villeautonome/Ville-Connectee/README.md

# Ville-Connectee
Création d'une ville connectée avec Arduino
