villeautonome/Ville-Connectee/rapport séances/Francesco/séance 5.md

# Cinquième séance du 3 Février 2023

- ##### Travail sur la base du projet

Durant ma cinquième séance j’ai commencé par tracer au crayon les différents éléments sur la base de notre nouvelle planche en bois pour avoir un aperçu de où placer chaque élément de notre projet. Ensuite on a fait des trou pour y faire passer les fils et composantes qu’on va placer à l’intérieur de la boîte. Voici le résultat:

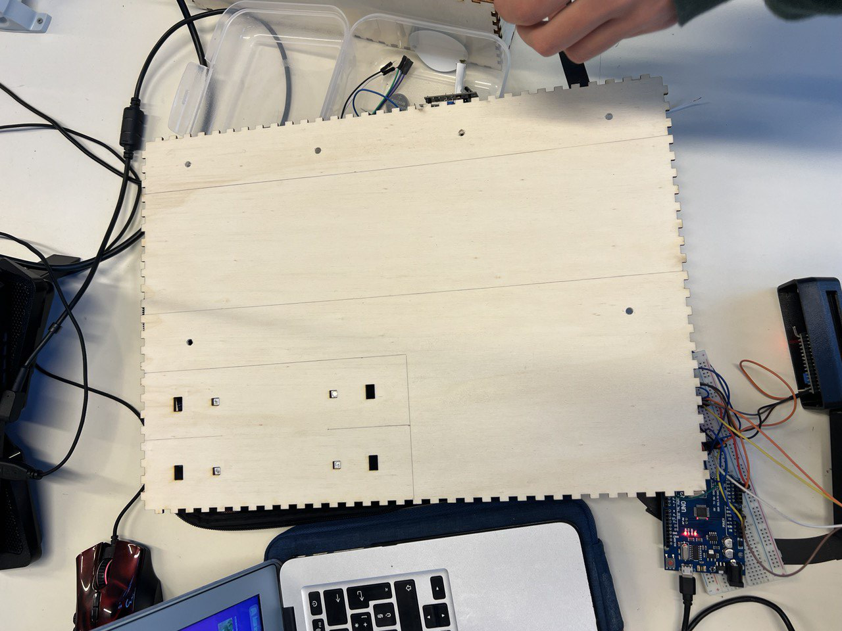
[picture p1: rapport séances/Francesco/images/planche_base.jpeg]
base du projet


- ##### "Création" de nouveaux capteurs de distance

On avait prévu d'utiliser un certain type de capteurs de distance pour notre projet, les capteurs TCRT5000, sauf qu'on en avait que 2 sur 4 du coup on a dû trouver une solution. J’ai alors soudé le capteur optique du TCRT5000 dans un capteur de proximité à infrarouges FC 51, parce que nous avions besoin de la forme rectangulaire du capteur optique du TCRT5000. Une fois la soudure complétée, j'ai vérifié que le capteur fonctionnait bien. On peut voir ici un capteur optique du TCRT5000 ainsi que le résultat final de la soudure:

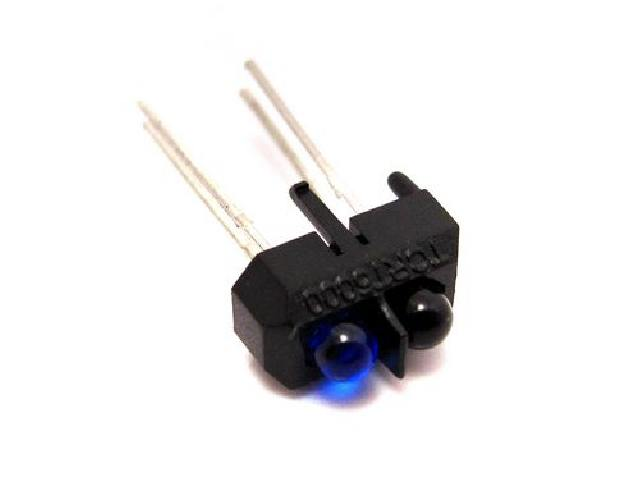
[picture p2: rapport séances/Francesco/images/tcrt5000.jpg]
capteur optique du TCRT5000

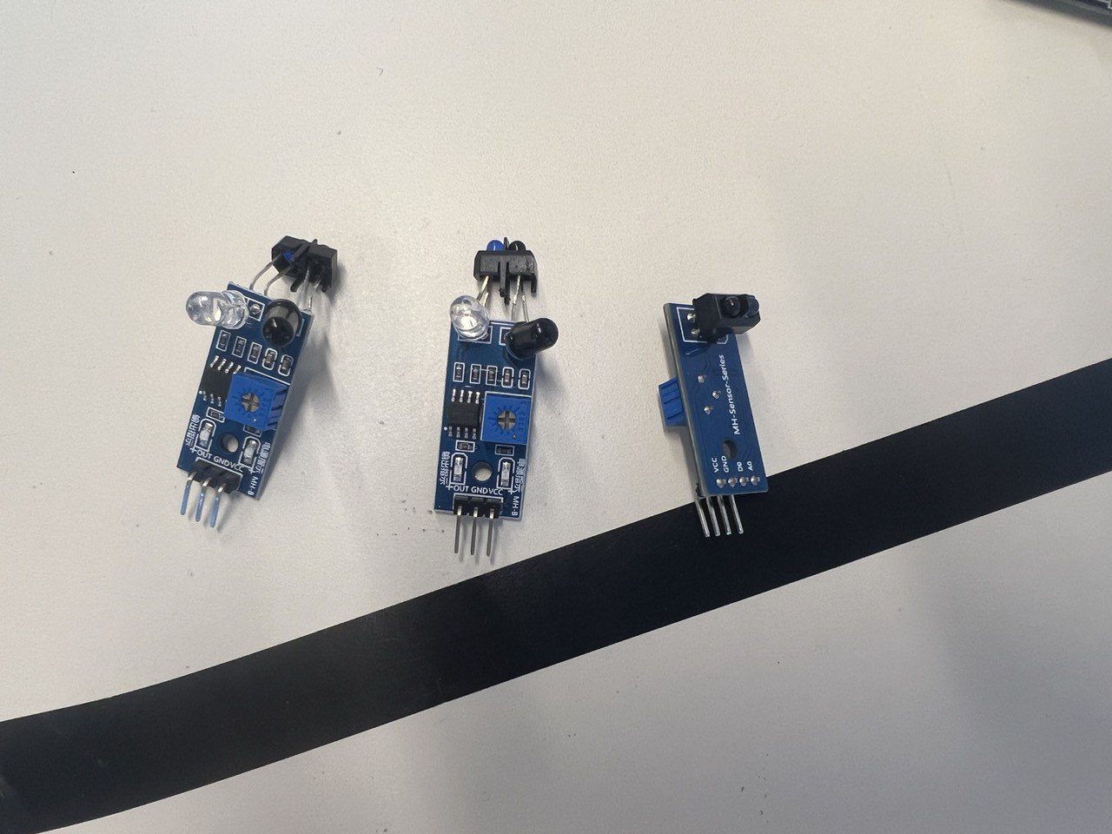
[picture p3: rapport séances/Francesco/images/capteurs_distance.jpeg]
soudure des capteurs de distance


- ##### 2 écrans sur une carte Arduino Uno et unification du code

Le reste de la séance j’ai cherché comment pouvoir connecter deux écran lcd sur une seule carte grâce au module i2c. Il a fallu souder dans l’un des deux modules une encoche (ici la A0) afin de lui changer d’adresse. Par défaut l’adresse d’un écran avec le module i2c est 0x27 mais en soudant l’adresse de la deuxième carte a changé en 0x26. On peut voir la soudure et l'adresse de chaque écrans que j'ai récupéré grâce au scanneur i2c dont le code est [ici](https://github.com/villeautonome/Ville-Connectee/tree/main/rapport%20séances/Francesco/codes/I2C_scanner.ino): 

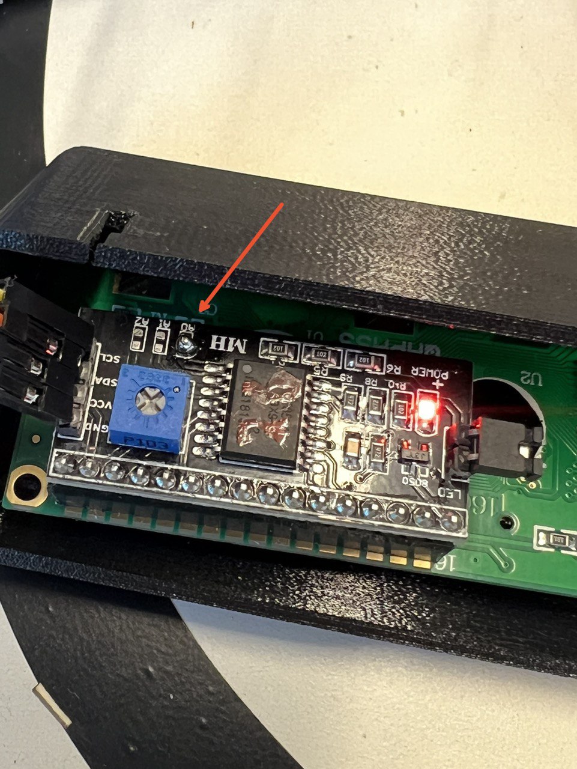
[picture p4: rapport séances/Francesco/images/ecrans2_A0.jpeg]
écrans soudé sur A0
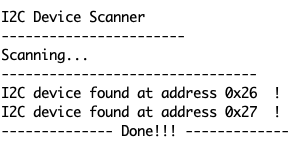
[picture p5: rapport séances/Francesco/images/I2Cscanner.png]
résultat scanner I2C
          

Une fois l’opération terminée j’ai effectué le montage est j’ai vérifié si on avait bien deux affichages différents dans les cartes grâce à un [code test](https://github.com/villeautonome/Ville-Connectee/tree/main/rapport%20séances/Francesco/codes/test_2_ecrans.ino). On peut voir le montage qu'il faut faire ainsi que le résulta: 

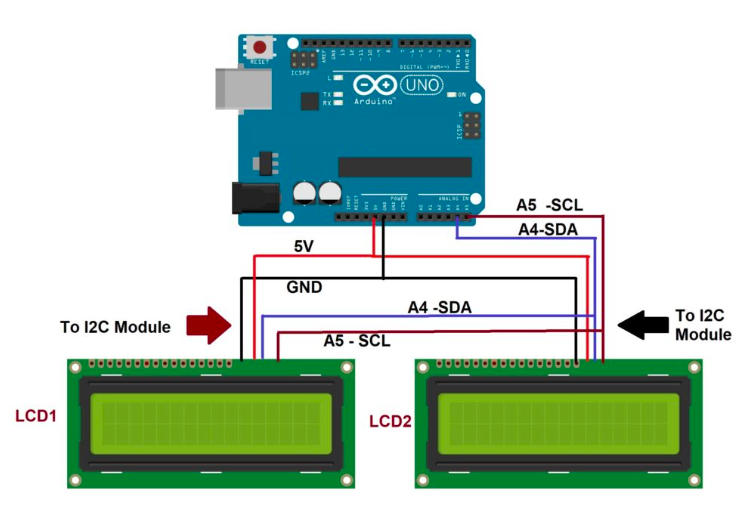
[picture p6: rapport séances/Francesco/images/montage_2ecrans.png]
montage 2 écrans
 
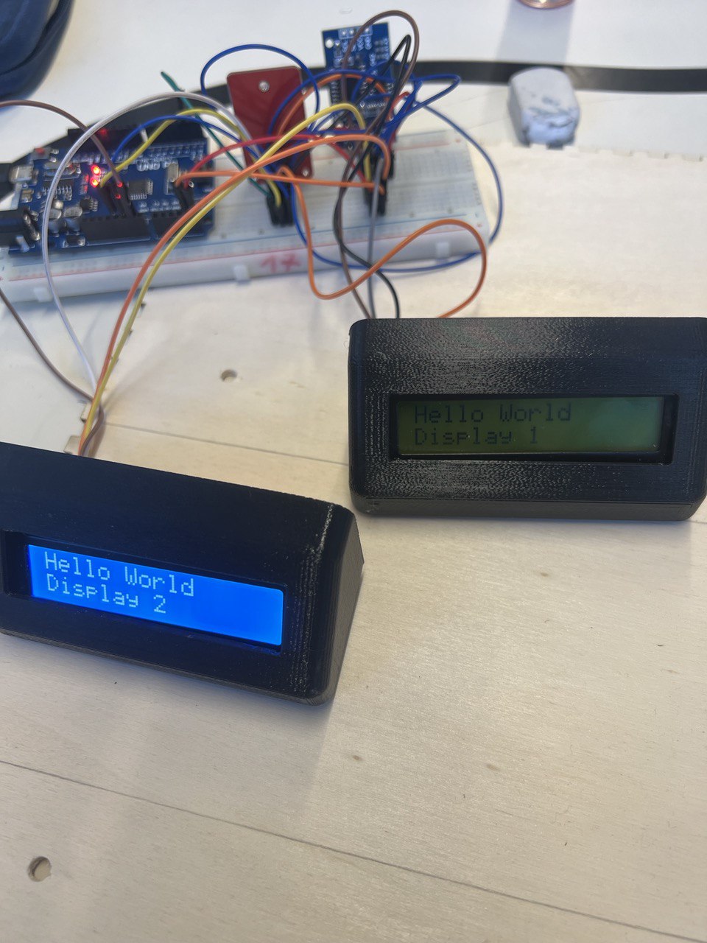
[picture p7: rapport séances/Francesco/images/test_2ecrans.jpeg]
test 2 écrans soudé
  

J’ai donc unifié le code que j’avais écrit avec celui de mon binôme puisque maintenant on peut utilisé une seule carte arduino uno étant donné que notre problème principal était le fait qu’on n’arrivait pas à utiliser deux écrans relié à une même carte arduino. Il y a le code [ici](https://github.com/villeautonome/Ville-Connectee/tree/main/rapport%20séances/Francesco/codes/version_unie.ino) et les deux écrans avec ce code ici: 

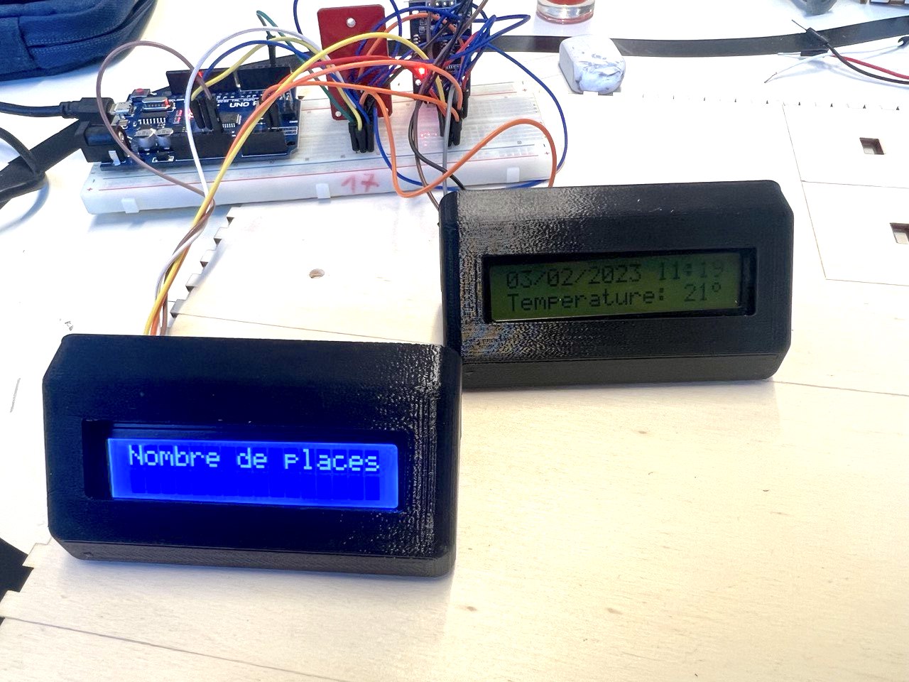
[picture p8: rapport séances/Francesco/images/resultat_2ecrans.jpeg]
vérification 2 écrans
