villeautonome/Ville-Connectee/rapport séances/Francesco/séance 3.md

# Troisième séance du 13 Janvier 2023

- ##### Travail sur les écrans

Durant ma troisième séance j'ai souder le deuxième écran et réglé à l’aide du professeur le potentiomètre pour pouvoir l’utiliser. Ensuite j'ai récupéré les pièces imprimées en 3D qui vont s'enboîter dans l'écran pour pouvoir le poser sur une surface plane, il a fallu donc visser les écrans avec la pièce pour que le tout soit stable. Voici le résultat obtenu:

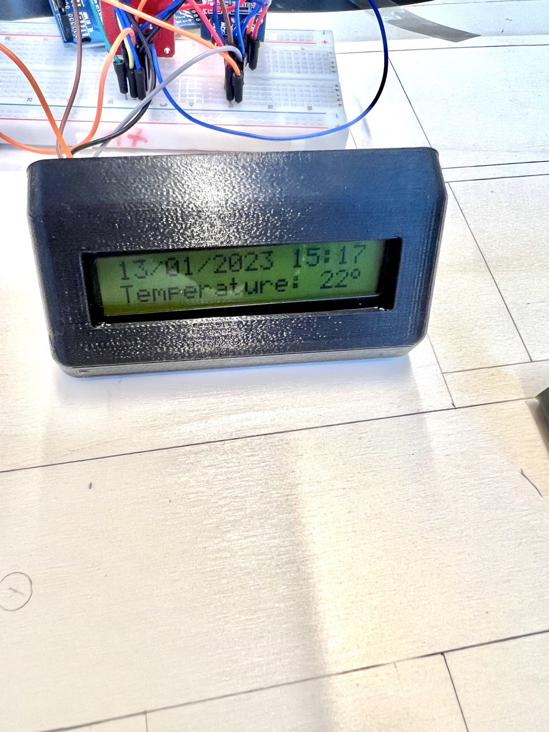
[picture p16: rapport séances/Francesco/images/meteo_boite.jpeg]
“meteo_boite”

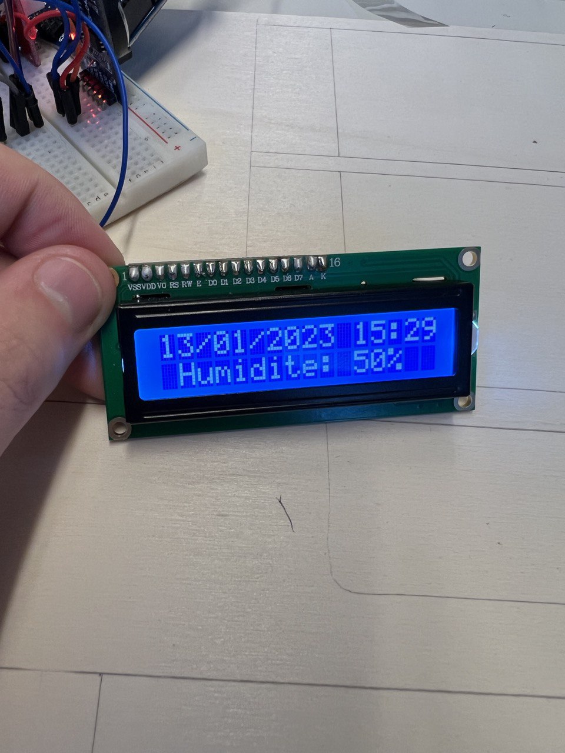
[picture p17: rapport séances/Francesco/images/ecran2.jpeg]
“écran2”


- ##### Travail au Fablab

J'ai récupéré les dernières pièces du lampadaire. Ensuite il a fallu finir de souder les câbles avec les led et poncer les dernières "vitres" restantes pour pouvoir avoir nos lampadaires. Au total on en a fait 8. 
J'ai réaliser la base de notre projet, en découpant une planche en bois qui fait 3mm d'épaisseur et 30cm x 40cm de taille. Une fois cela fait, j’ai tracé au crayon toutes les traces nécessaires afin de visualiser l’ensemble des parties de notre ville pour savoir aussi un peu où poser chaque élément. Voici un peu l’idée de ce qu’on devrai obtenir:

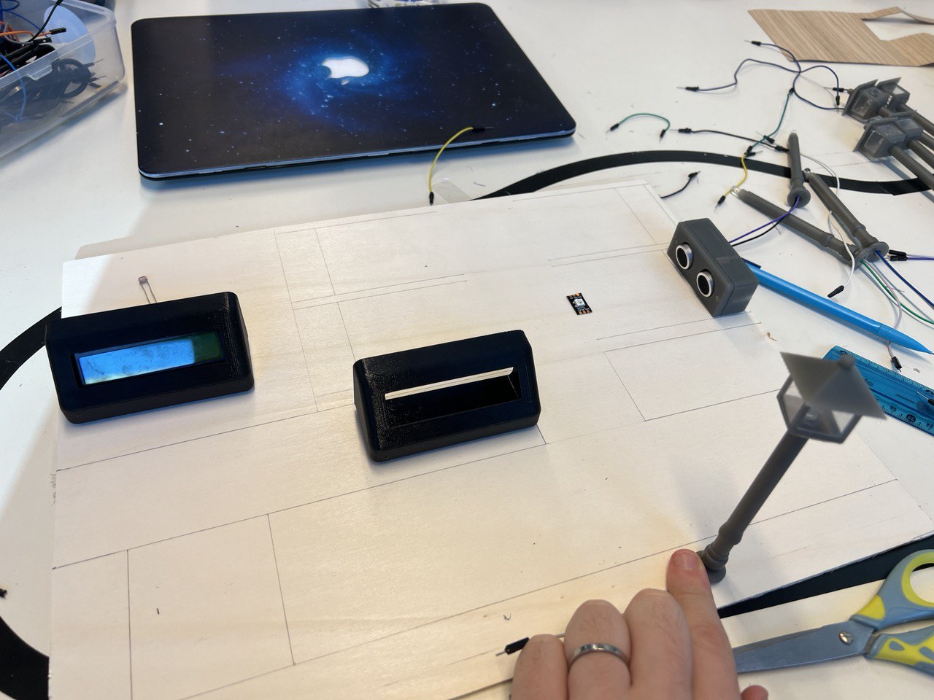
[picture p18: rapport séances/Francesco/images/base_init.jpeg]
base du projet en construction


- ##### Travail sur le code

A la fin de notre séance, on a intégrer l’écran dans le code qui s'occupe des places de parking afin de pouvoir visualiser le nombre de places restantes. On peut voir une led rouge si la place est occuppée et une verte si elle est disponible. Voici pour l'instant la conception pour 2 places:

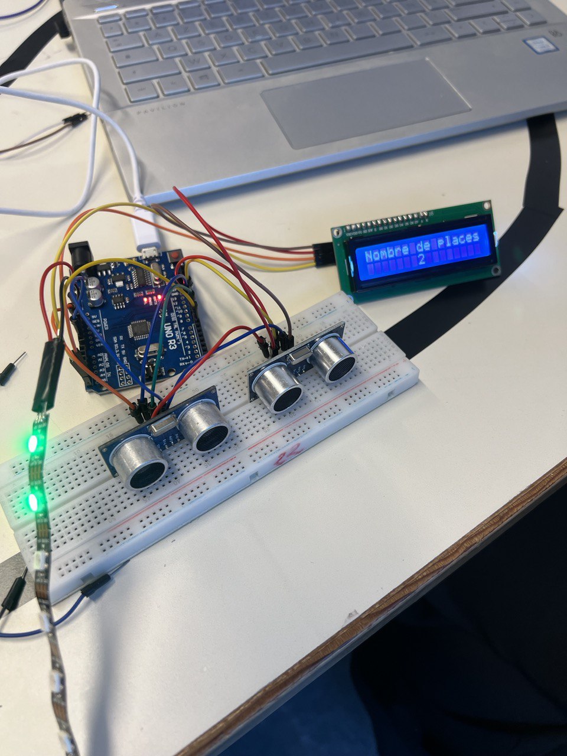
[picture p19: rapport séances/Francesco/images/parking_2.jpeg]
2 places disponibles

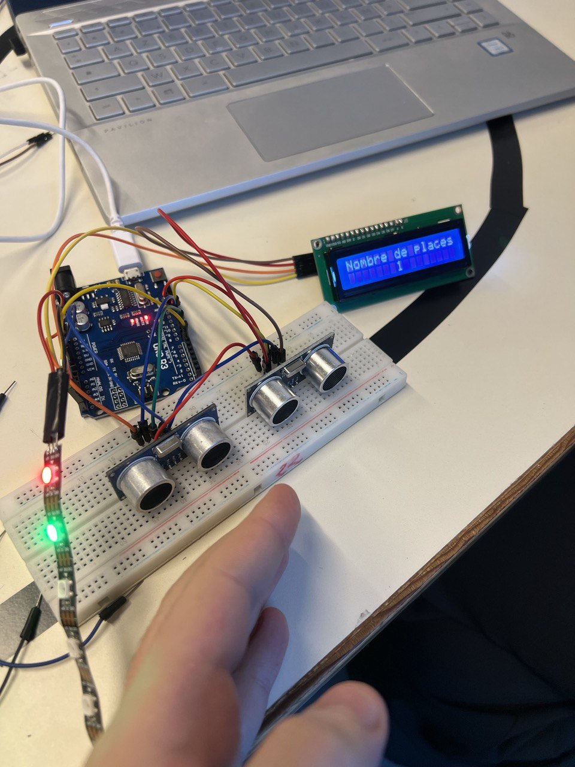
[picture p20: rapport séances/Francesco/images/parking_1.jpeg]
1 place disponible

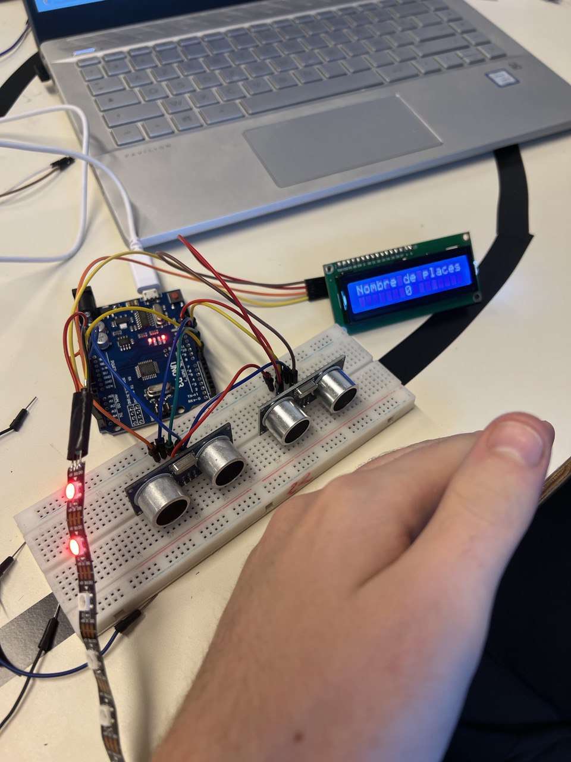
[picture p21: rapport séances/Francesco/images/parking_0.jpeg]
0 places disponibles
