villeautonome/Ville-Connectee/rapport séances/Francesco/séance 2.md

# Deuxième séance du 6 Janvier 2023

- ##### Travail sur la station météo

Ensuite j'ai amélioré mon code de la station météo pour qu’elle puisse afficher la date et l’heure exacte en première ligne, et aussi la température (en degrés) ainsi que l’humidité (en %) sur la deuxième ligne à des intervalles de temps de 5 secondes. Il a fallu faire un affichage par intervalle de temps car la taille de l'écran est assez réduite pour que tous les éléments puissent s'afficher. Le code est disponible [ici](https://github.com/villeautonome/Ville-Connectee/blob/main/rapport%20séances/Francesco/codes/meteo.ino). Voici l'affichage:

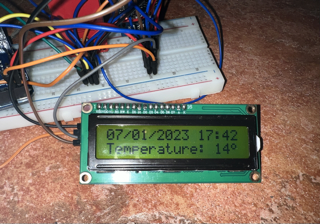
[picture p22: rapport séances/Francesco/images/meteo_temp_alt.png]

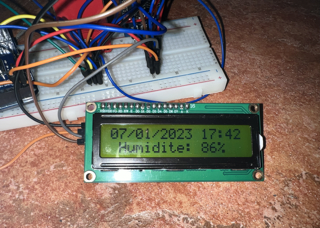
[picture p23: rapport séances/Francesco/images/meteo_hum_alt.png]


- ##### Travail au Fablab

Durant ma deuxième séance de arduino on est allé au Fablab pour la création des lampadaires qui seront présent dans notre ville. Après avoir préalablement imprimé les pièces en résine, on a percé la partie où la led sera installée pour pouvoir emboiter le poteau avec sa partie supérieure. Ensuite il a fallu qu’on soude les câbles avec les led et appliquer une gaine thermorétractable pour que rien ne s’endommage. Une fois cela réalisé j’ai coupé sur du pvc transparent des petits morceaux (qu’il a été un peu compliqué à couper) qui seront utilisés pour faire les vitres de nos lampadaires. Une fois les petites pièces poncées, il a simplement fallu les emboiter dans notre structure en résine. J’ai donc limer les pièces en résine afin d’enlever toute partie en excès pour enfin assembler les tout et tester si la led s’allumait bien. Voici le résultat du lampadaire assemblé et allumé:

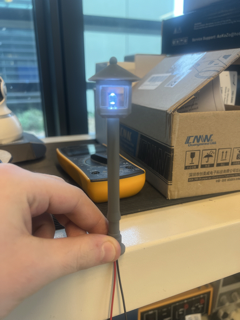
[picture p24: rapport séances/Francesco/images/lampadaire.png]
“lampadaire”


- ##### Fin de séance

A la fin de notre séance, notre professeur nous a donné les pièces ainsi que le code pour mettre en fonctionnement des led RGB et aussi un autre écran LCD que j’ai soudé pour pouvoir l’utiliser dans notre parking afin d’afficher le nombre de places disponibles.
