villeautonome/Ville-Connectee/rapport séances/Célia/Rapport séance 20221216 Roess.pdf

Célia Roess G1 | Rapport de séance du 16/12/2022
- Réalisation du système de lampadaire qui s’allume dès que la luminosité est faible sur la plaque d’essai
Grâce à une résistante variant en fonction de la luminosité, on mesure la tension aux bornes de ce composant. Si la tension est inférieure à un certain palier (ici 4V), celle signifie que la luminosité extérieure est faible, on va alors allumer les LED qui sont reliés à la sortie n°2.

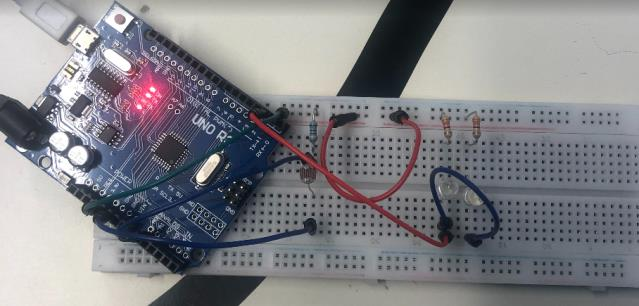
[picture p64: figure]

Figure 1 - Montage avec la résistance variant selon la luminosité et 2 LED blanches

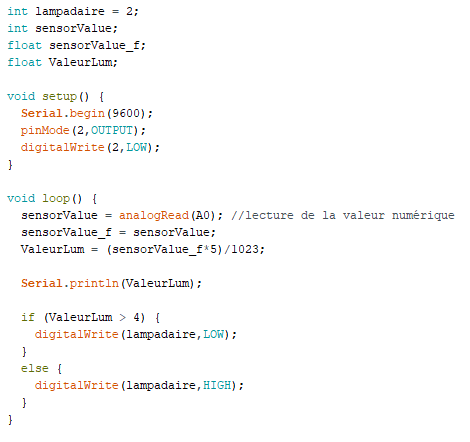
[picture p65: figure]

Figure 2 - Code pour l’allumage des LED si la luminosité est faible

- Début de la conception 3D du lampadaire
Une première idée de conception 3D d’un lampadaire a été modélisée sur le site onShape.

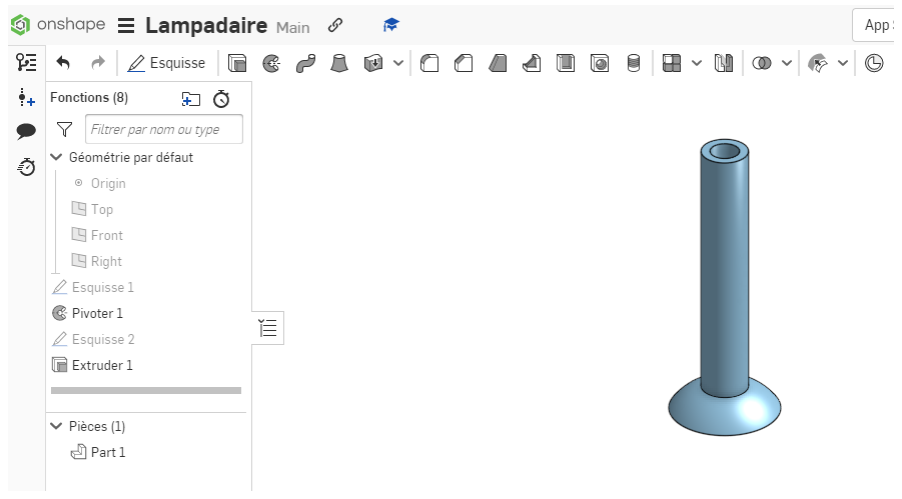
[picture p66: figure]

Figure 3 - Modélisation du corps du lampadaire
