villeautonome/Ville-Connectee/rapport séances/readme

ce dossier contient les rapports de chaque séance
