villeautonome/Ville-Connectee/rapport séances/Francesco/readme

Ce dossier contient tous les rapports de séeances ainsi que les codes et les images nécessaires à documenter l'avancement effectué par moi pour le projet
