villeautonome/Ville-Connectee/rapport séances/Francesco/codes/readme

voici les codes des différentes partie du projet que j'ai écrit
