villeautonome/Ville-Connectee/rapport séances/Francesco/séance 8.md

# Huitième séance du 3 Mars 2023

Durant ma huitième et dernière séance j'ai travaillé sur une version améliorée de notre projet.
Au départ on avait décidé de garder le projet qu'on avait réalisé et en faire un deuxième à côté mais amélioré.

- #### Travail sur un la version 2 du projet

Je suis allé au fablab pour souder un nouvel écran, souder les led avec les résistances pour les nouveaux lampadaires et réaliser une nappe pour que tous les fils soient bien reliés entre-eux. De plus j’ai découpé une nouvelle boîte en bois même s’il y a eu quelques soucis à la faire à cause des dimensions et du manque de planches en bois. Au final le tout a été réalisé:

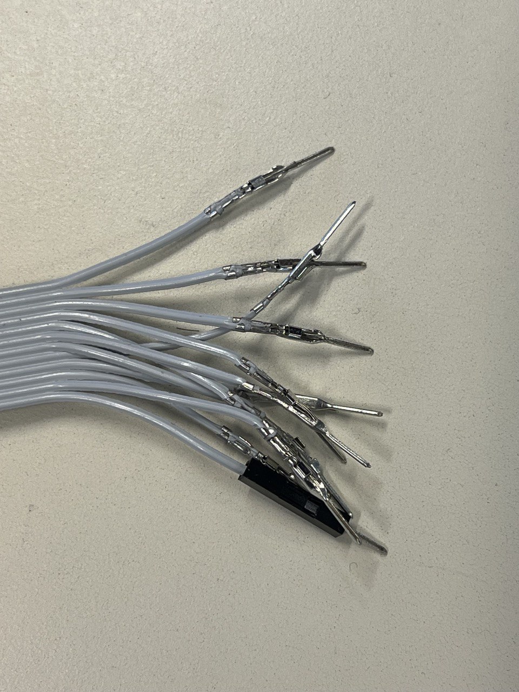
[picture p69: rapport séances/Francesco/images/nappe.jpeg]
nappe
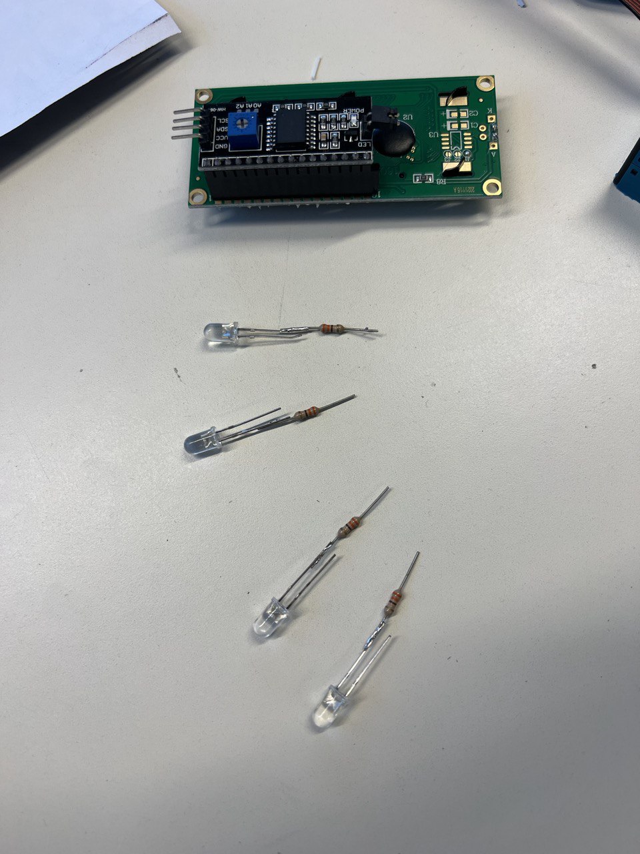
[picture p70: rapport séances/Francesco/images/soudure 1.jpeg]
soudure de l'écran et des leds
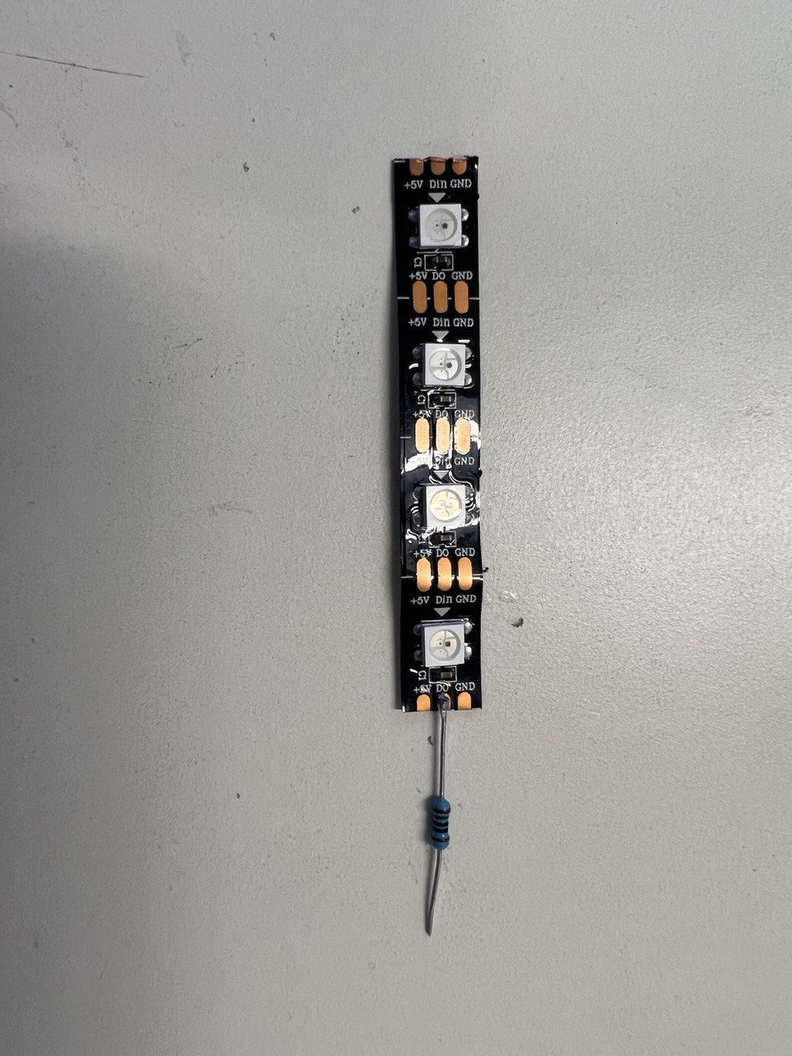
[picture p71: rapport séances/Francesco/images/soudure 2.jpeg]
soudure des leds rgb
    écran lcd boite 2

Malheureusement cette deuxième version ne peut pas aboutir car on a eu un manque de temps...

- #### Travail sur l'entrée du parking et matrice led

Ensuite j’ai récupéré une matrice led 8x8 qui sera placée à l’entrée du parking et qui affichera tout simplement le nombre de places disponibles. Dans le cas où il n’y aurait aucune place disponible toute la matrice led se mettrait à clignoter. Pour cela j’ai alors dû utiliser [ce site](https://ijhack.nl/page/led-matrix-generator) pour pouvoir coder chaque led de la matrice qui sera indiqué en binaire pour pouvoir après réécrire chaque ligne en hexadécimal pour mon code. Dans le GitHub il y a le code pour la matrice simple [ici](https://github.com/villeautonome/Ville-Connectee/tree/main/rapport%20séances/Francesco/codes/matrice%208x8) et la versione unifié que j’ai fait en intégrant aussi le parking [ici](https://github.com/villeautonome/Ville-Connectee/blob/main/rapport%20séances/Francesco/codes/Parking_matrice_led.ino). Voici le résultat que cela donne:

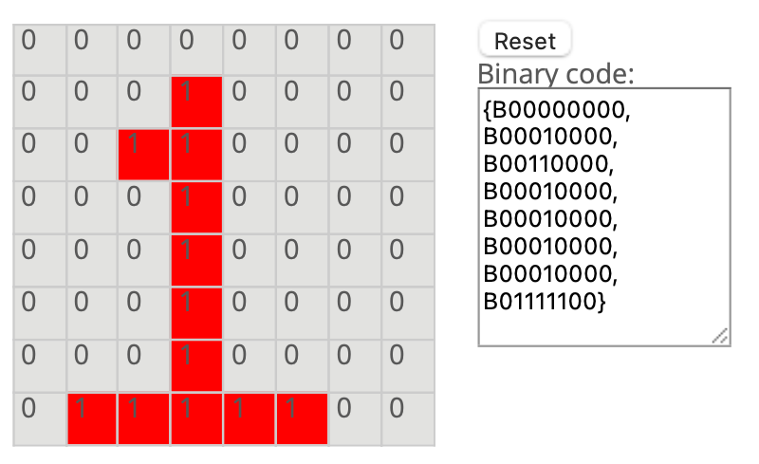
[picture p72: rapport séances/Francesco/images/chiffre1.png]
chiffre 1 site
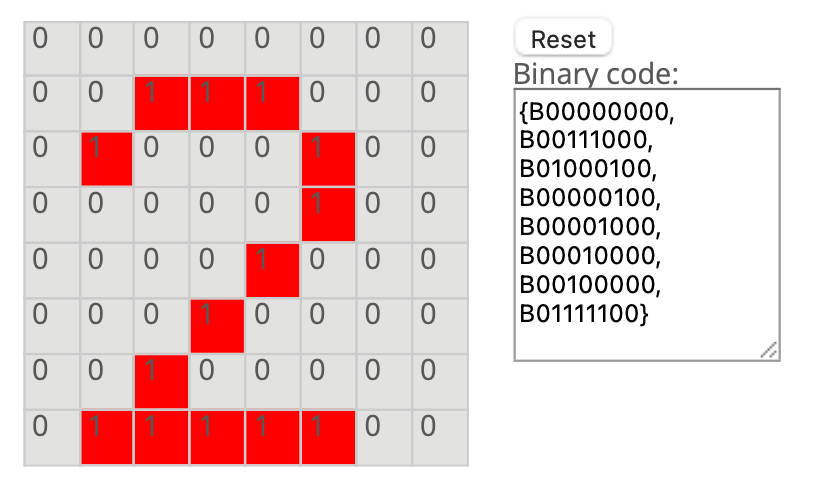
[picture p73: rapport séances/Francesco/images/chiffre2.png]
chiffre 2 site
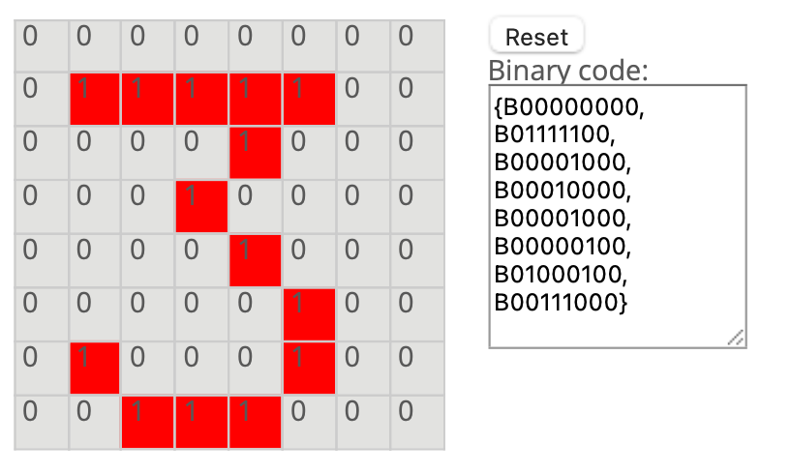
[picture p74: rapport séances/Francesco/images/chiffre3.png]
chiffre 3 site
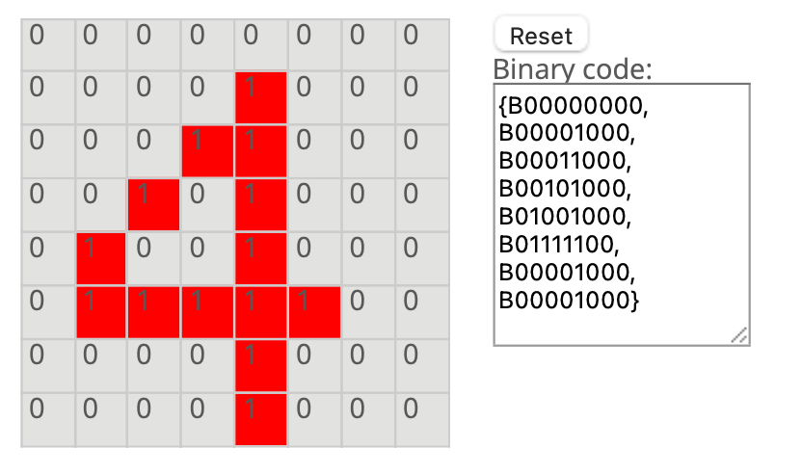
[picture p75: rapport séances/Francesco/images/chiffre4.png]
chiffre 4 site
   

matrice 1 matrice 2 matrice 3 matrice 4

2 places parking 4 places parking parking complet parking complet

De plus j’ai réaliser un fichier svg pour réaliser une petite boîte qui va contenir la matrice led et qu’on va placer à l’entrée du parking. Voici le fichier ainsi que le résultat final avec un trou dans la boîte pour voir la matrice:

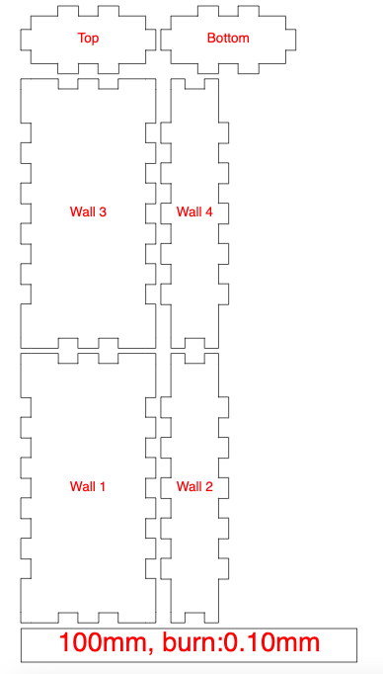
[picture p76: rapport séances/Francesco/images/boite_matrice_svg.png]
boite svg
 boite matrice

- #### Travail sur détecteur de poussière

Grâce à mon professeur j’ai compris un peu mieux comment utiliser le module de capteur de poussière DSM501A pm2,5. On a pu faire ensemble le montage et tester ce capteur grâce à un code trouvé en ligne et qui est disponible [ici](https://github.com/villeautonome/Ville-Connectee/blob/main/rapport%20séances/Francesco/codes/detecteur_particules.ino). Le détecteur renvoie le nombre de particules pour 1/100 de pied cube (environ 1/100 tous les 0,03 mètres cubes). Voici la photo du montage:

détecteur particules
     
J’ai réussi à afficher les valeur sur l’écran lcd que j’avais soudé préalablement du coup j’ai pu unifier cette composante avec le code de la station météo et des lampadaires, le code est [ici](https://github.com/villeautonome/Ville-Connectee/blob/main/rapport%20séances/Francesco/codes/lampadaires_meteo_v2.ino).
