villeautonome/Ville-Connectee/rapport séances/Francesco/séance 7.md

# Septième séance du 17 Février 2023

Durant ma septième séance j'ai travaillé sur l'ensemble du projet et assemblé le tout pour qu'à la prochaine séance tout soit prêt, étant donné que c'est la dernière avant la présentation orale finale.

- #### Travail sur un côté du projet

Je suis allé au fablab pour uiliser la perceuse laser afin de faire 2 trous sur l'un des côtés de notre boîte afin de pouvoir y faire passer les cables d'alimentation pour les cartes Arduino. Pour cela j'ai du créer un fichier avec Inkscape avec un rectangle de 1cm de hauteur et 1,5cm de largueur, ce rectangle correspond au trou pour faire passer le cable. J'ai alors positionné ma planche en bois dans la machine, positionné le laser aux 2 endroits où je voulais découper et une fois la machine lancée les deux trous ont été découpés.

trous sur coté de boite


- #### Achèvement de la station météo

Une fois que le professeur m'a procuré un morceau d'herbe synthétique pour les maquettes (différente su gazon) j'ai découpé avec les ciseaux un carré dans un côté pour laissé la place à notre capteur de luminosité et ensuite j'ai utiliser la perceuse pour faire un trou afin d'y faire passer les fils qui vont relier l'écran de la station météo.  

herbe


Après tout ce travail j'ai alors collé sur la planche en bois ce bout d'herbe avec de la colle super forte et relié tous les fils afin de tester le tout. On peut voir le résultat final :

station météo final


- #### Finalisation des lampadaires et montage final

Tous les composants de notre projet ont été branchés sur les deux plaques d'essai ou collés sur la planche en bois. J'ai dû soûder une première fois 2 capteurs de distance étant donné qu'ils s'étaient désouder et ensuite aussi une deuxième fois après avoir collé le capteur sur la planche en bois, cette deuxième fois a été un peu plus compliquée étant donné qu'il y avait tous les fils et qu'il fallait tenir la planche en bois un peu surélevée. On peut voir ici l'intérieur de notre boite avec tous les fils, les plaquettes ainsi que les cartes arduino:

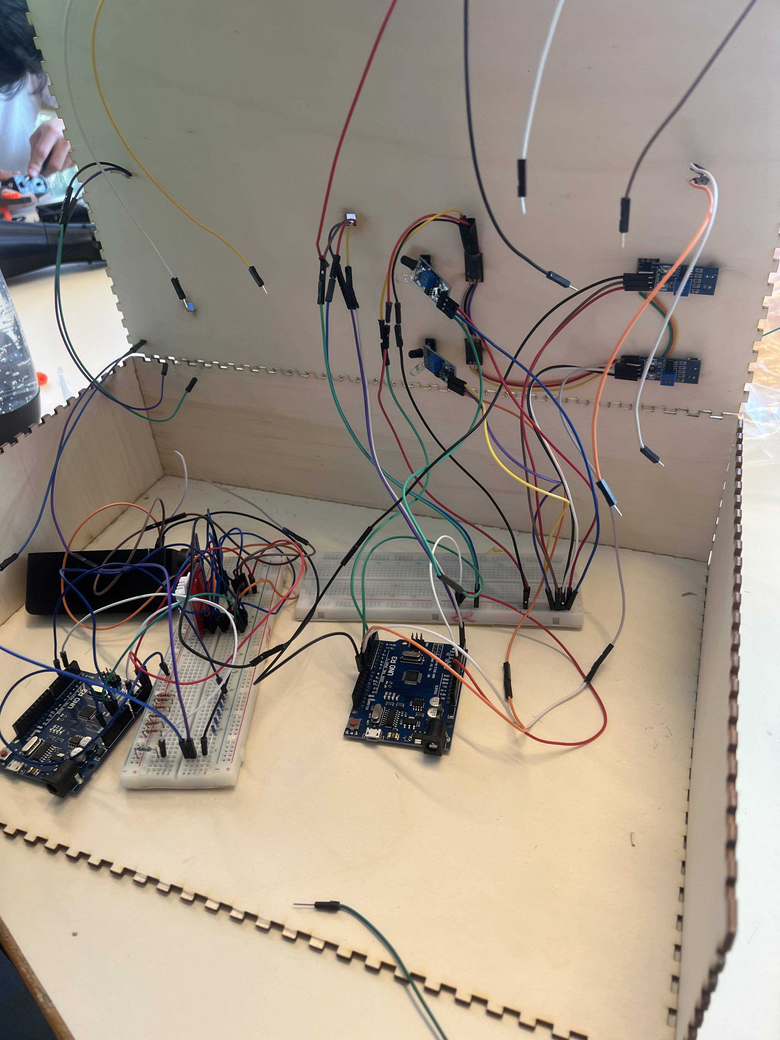
[picture p80: rapport séances/Francesco/images/cablages.jpeg]
intérieur boite


Ensuite avant de coller les lampadaires avec la super colle on les a testé, on s'est aperçu que 2 lampadires étaient défaillants. On peut voir un exemple ici:
lampadaire défaillant
 La solution a été relativement simple, pour un lampadire il y avait un problème de cablâge et pour l'autre il a fallu repositionner la résistance du lampadire dans la plaquette.

On a alors collé les deux cartes Arduino dans notre boîte avec du scotch double face (biadhésif) et de la super colle. Je vous laisse ici une vue latérale de notre projet:
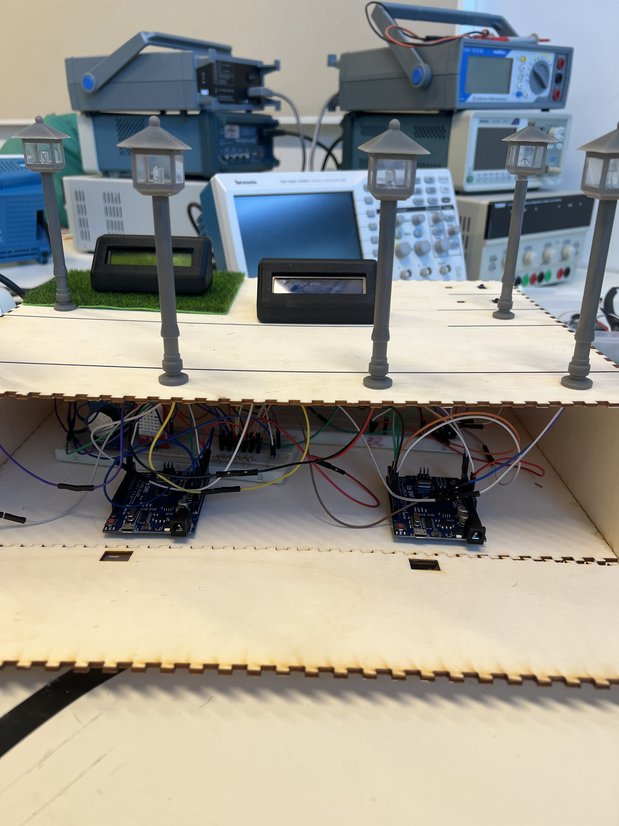
[picture p82: rapport séances/Francesco/images/vue_laterale.jpeg]
vue latérale


On a donc fermé la boîte, collé des parties de celle-ci parce que les encoches qui permettent la fermeture ne tenaient pas, branché les deux cartes et testé si l'ensemble du projet fonctionnait.

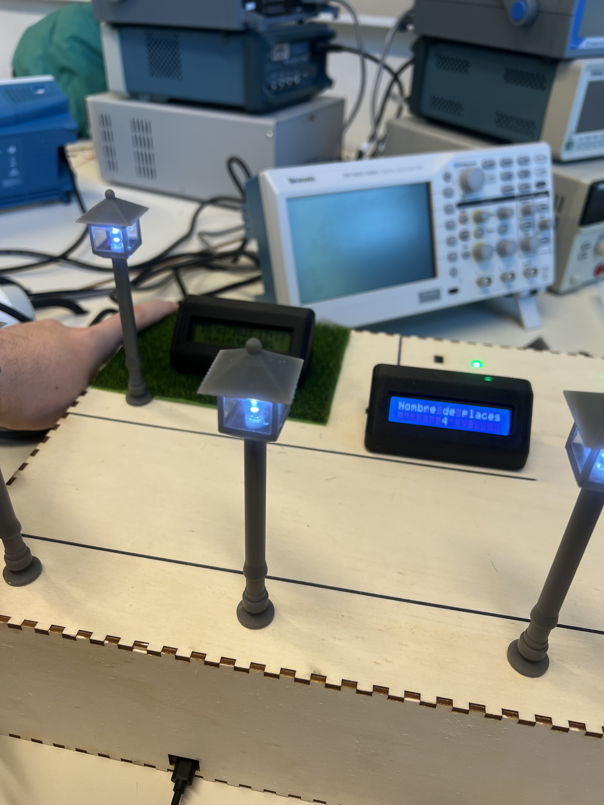
[picture p83: rapport séances/Francesco/images/lampadaire_allume.jpeg]
projet allumé

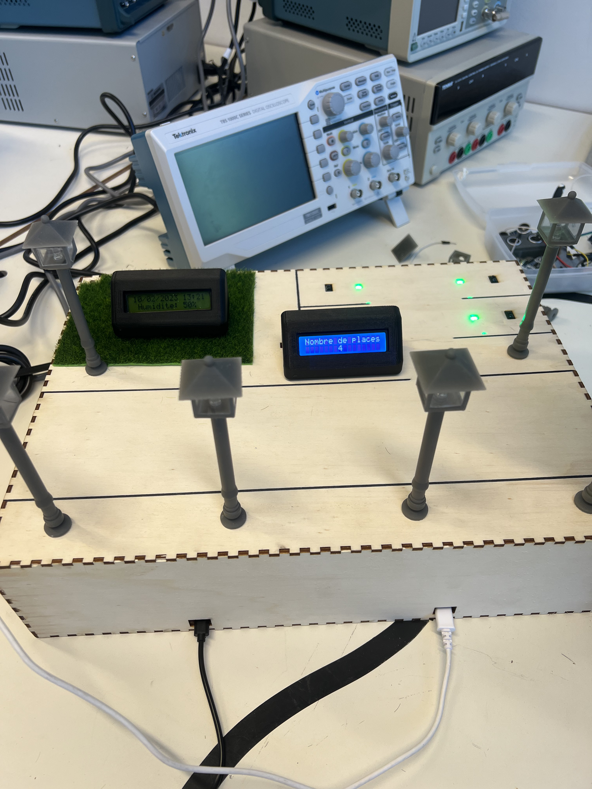
[picture p84: rapport séances/Francesco/images/lampadaire_eteint.jpeg]
ensemble du projet
