villeautonome/Ville-Connectee/rapport séances/Francesco/séance 6.md

# Sixième séance du 10 Février 2023

Durant ma sixième séance j'ai:

- #### Travail sur la base du projet

Réalisé des trous sur la maquette en bois de deux façon différentes:
- ###### grâce à une perceuse, pour y faire passer les fils de la résistance LDR photorésistante à laquelle je lui avait précédemment mis une gaine thermorétractable.
- ###### grâce à la découpeuse laser, pour y faire passer les fils des écrans. J'ai modélisé des carrés/rectangles un fichier .svg via le logiciel Inkscape et après avoir mis la planche en bois dans la machine et positionné le laser pour indiquer où couper, j'ai pu obtenir des coupes parfaites.  

Une fois cela fait, j'ai colorier les bords de la ville en noir comme vous pouvez le voir ici:

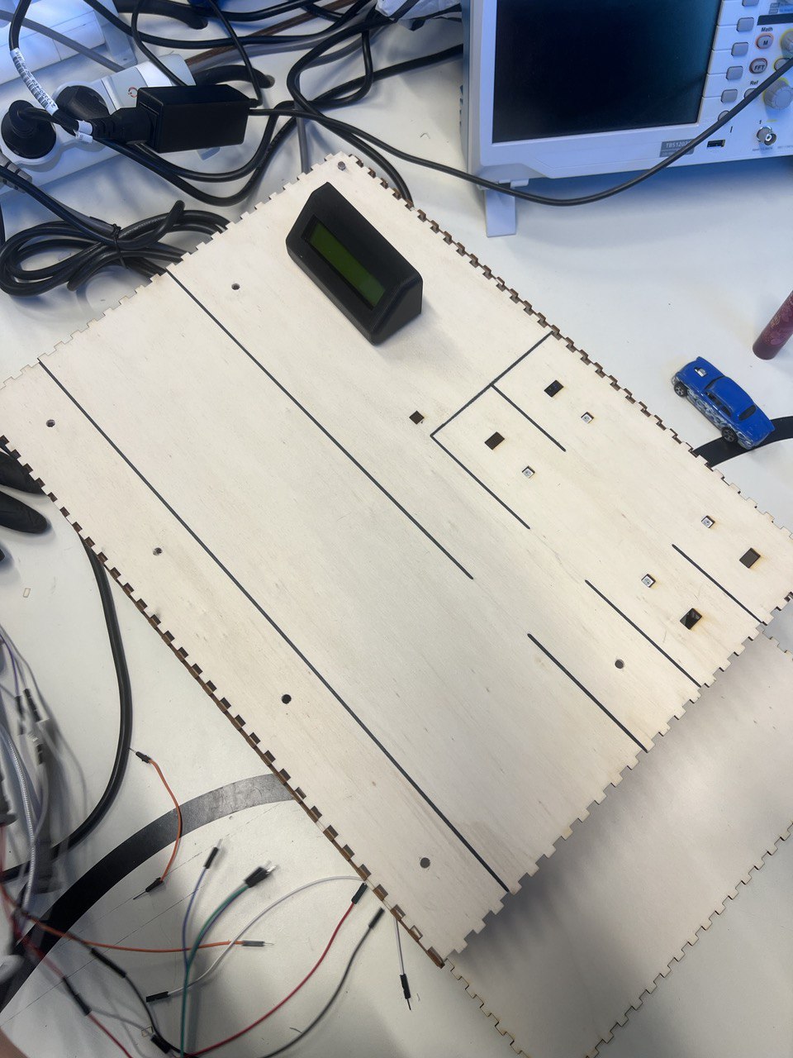
[picture p85: rapport séances/Francesco/images/planche_base_noir.jpeg]
base du projet fin


- #### Re-soudage d'un capteur de distance

La semaine dernière j'avais soudé des capteurs de distance car leur forme m'intéressait sauf que je me suis rendu compte en les testant aujourd'hui que l'un que j'avais fait ne fonctionnait plus, du coup j'ai dû en faire un nouveau.

- #### Collage des lampadaires et prolongation des fils

J'ai décidé de coller chaque partie qui compose notre lampadaire afin de pouvoir par la suite les coller sur notre base. J'ai donc collé la led avec le poteau du lampadaire et ensuite j'ai uni, toujours avec de la colle, le capuchon du lampadaire avec le poteau. Après avoir fait tout ça avec chaque lampadaire j'ai ajouté des fils qui partaient de la led pour qu'ils puissent atteindre la plaque d'essai. Je met ici une photo pour comprendre. 

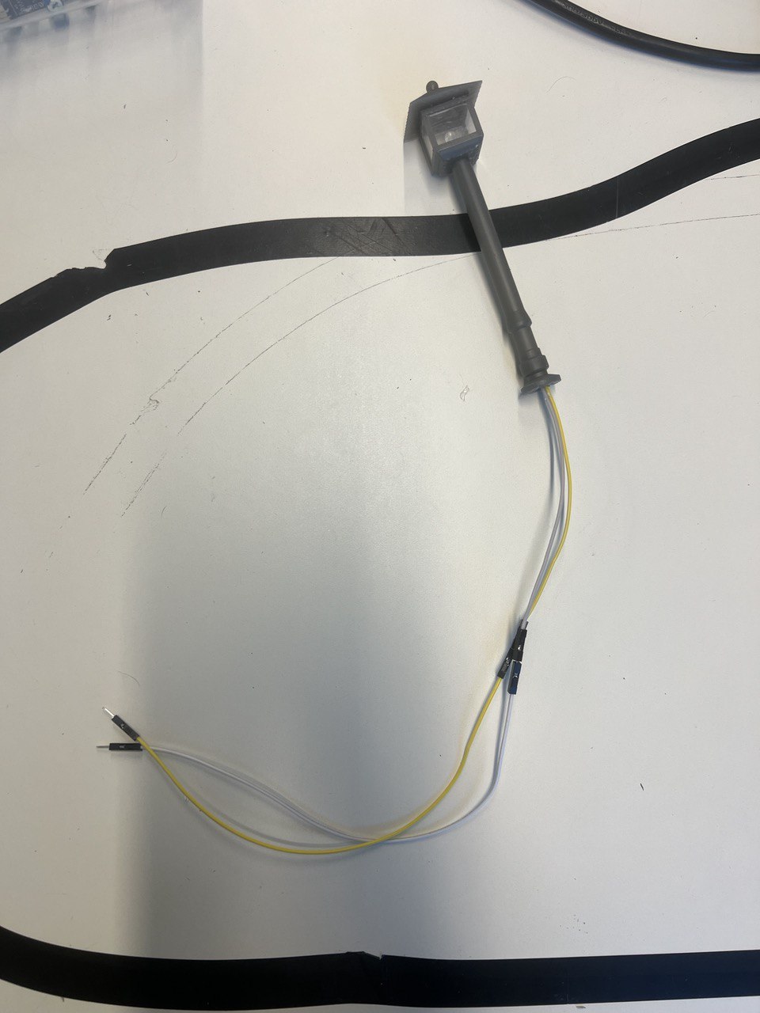
[picture p86: rapport séances/Francesco/images/lampadaire_long.jpeg]
lampadaire


- #### Écriture du code

Mon binome ne voulais pas utiliser deux écrans dans une même carte arduino du coup, j'ai re-écrit mon code afin d'y mettre la station météo ainsi que les lampadaires qui s'allument via la résistance LDR. Ce nouveau code est [ici](https://github.com/villeautonome/Ville-Connectee/tree/main/rapport%20séances/Francesco/codes/meteo_lampadaire.ino)
