villeautonome/Ville-Connectee/rapport séances/Francesco/séance 1.md

# Première séance du 16 Décembre 2022

Durant ma première séance de arduino pour le projet de la ville connecté j'ai créé sur Github le dossier de dépôt des séances, ensuite j’ai effectué avec mon binôme la liste des composants nécessaire à la réalisation de notre projet. Une fois le matériel récupéré je me suis concentré sur un aspect de notre ville connecté: la station météo (qui indique la date actuelle, l’heure ainsi que la température). J’ai appris à utiliser une écran LCD ainsi que le capteur thermique et barométrique DH22 et le RTC (Real Time Clock) qui mesure la date et l’heure et qui fonctionne avec une pile. Après avoir fait le montage nécessaire, installé les librairies nécessaires et écrit le code en arduino, j'ai pu vérifier que le tout fonctionnait et voici le résultat:

montage station

Ensuite j'ai donc modélisé sur OnShpae un "bloc" qui sera imprimé en 3D ou fabriqué à partir des matériaux à notre disposition qui sera positionné sur l'écran LCD afin de cacher les fils et le contour vert de l'écran comme on peut le voir dans l'image ci-dessus. Voici la modélisation du bloc et le résultat qu'on devrait obtenir: 

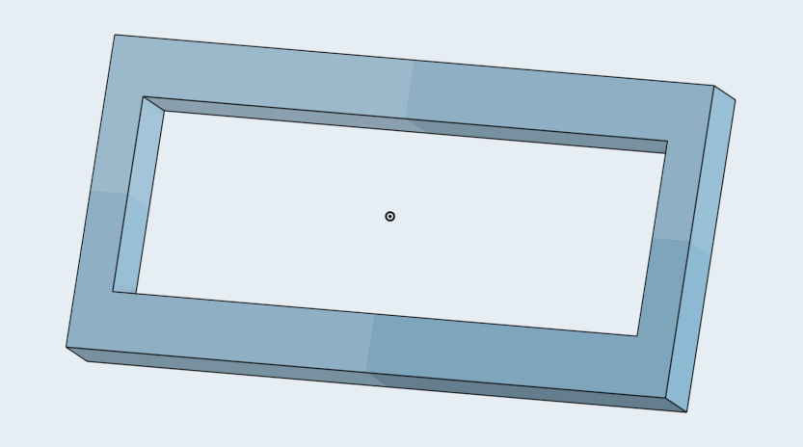
[picture p87: rapport séances/Francesco/images/bloc_station.png]
bloc station

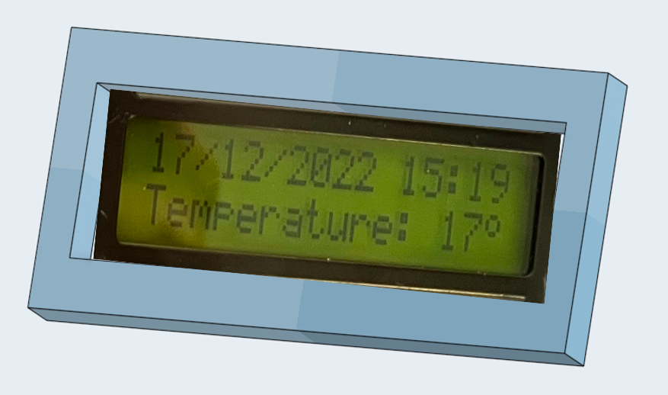
[picture p88: rapport séances/Francesco/images/resultat_bloc_station.png]
résultat bloc station


Le code sera dispobile dans le dossier "code".
Et voici les montages pour la station météo:
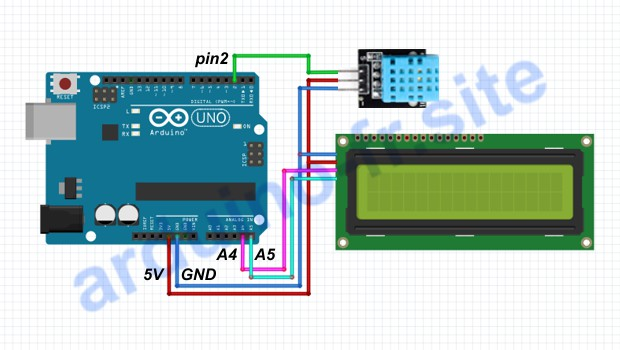
[picture p89: rapport séances/Francesco/images/meteo_lcd.jpg]

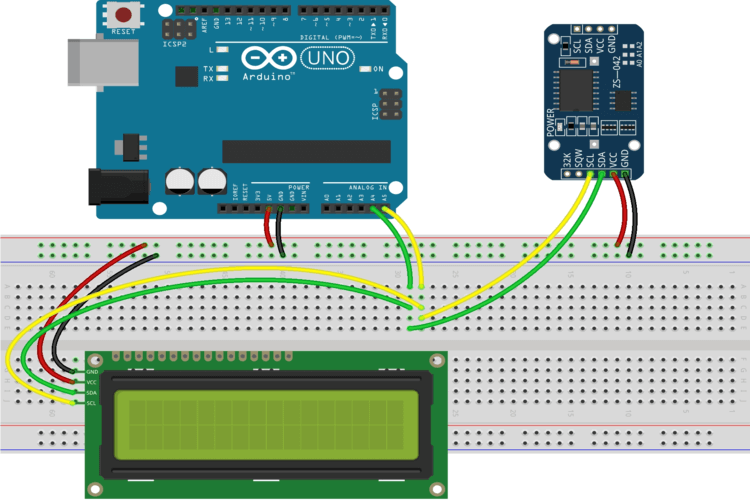
[picture p90: rapport séances/Francesco/images/rtc_lcd.png]
