villeautonome/Ville-Connectee/rapport séances/Francesco/images/matrice_8x8.png

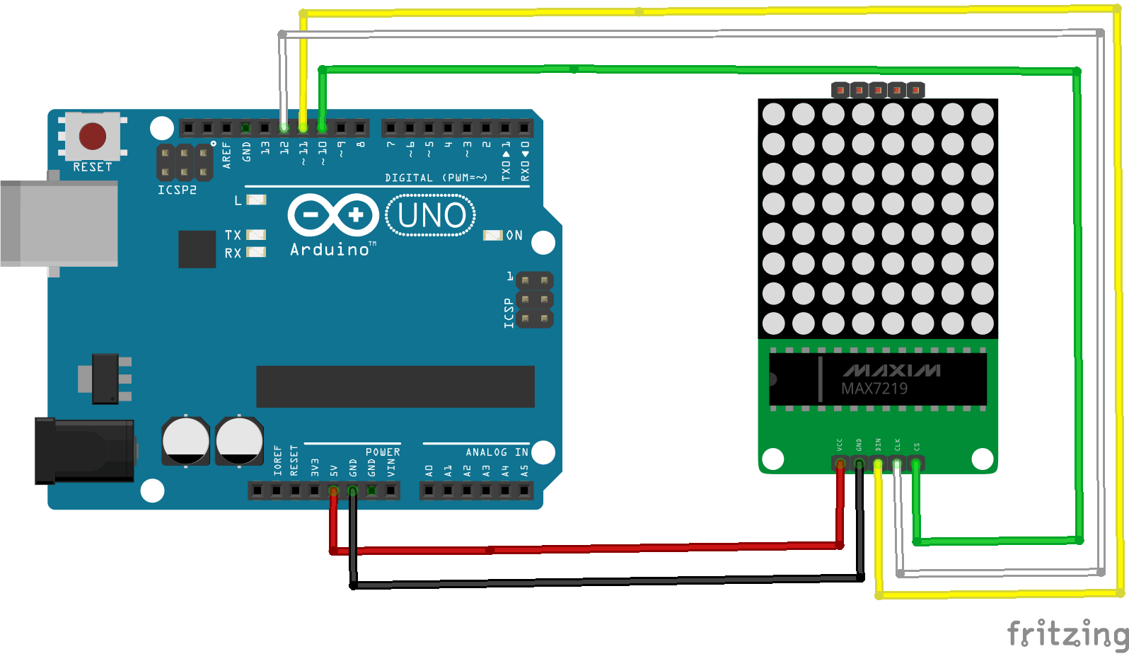
rapport séances/Francesco/images/matrice_8x8.png
