villeautonome/Ville-Connectee/Projet Arduino.pdf

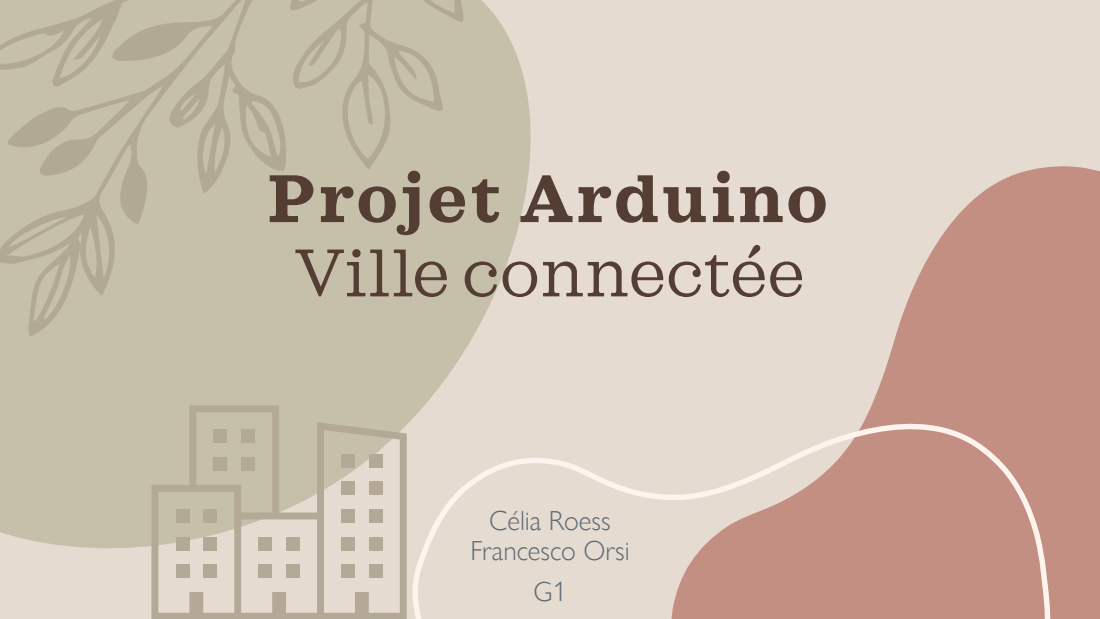
[picture p103: page 1]
Projet Arduino Ville connectée; Célia Roess Francesco Orsi

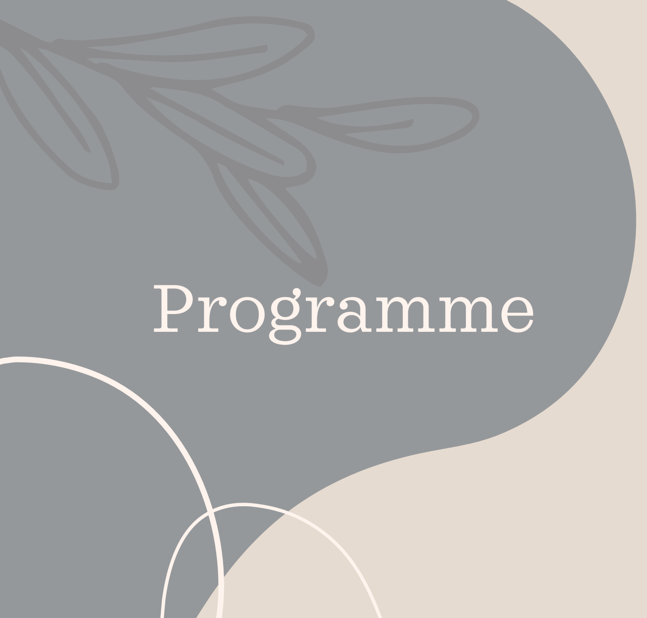
[picture p104: figure]
Programme

## INTRODUCTION

3

## PRÉSENTATION GÉNÉRALE

4

## MATÉRIEL UTILISÉ

6

## EXPLICATION DÉTAILLÉE

7

## SYNTHÈSE

15

# Introduction

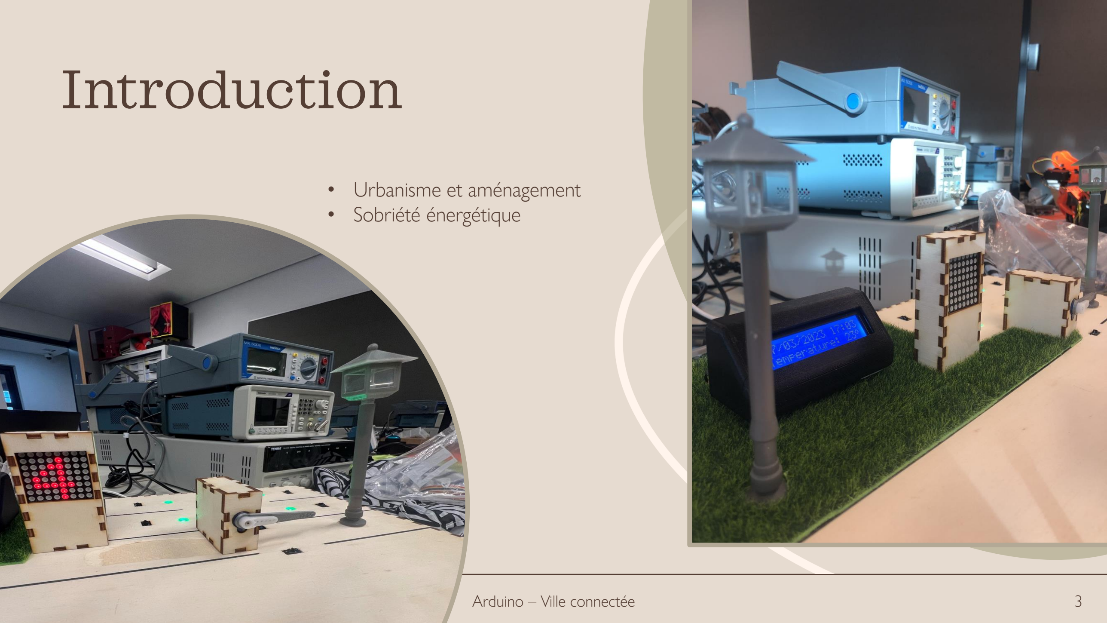
[picture p105: page 3]

10/03/2023 | Arduino – Ville connectée | 3
- Urbanisme et aménagement
- Sobriété énergétique

# Présentation générale

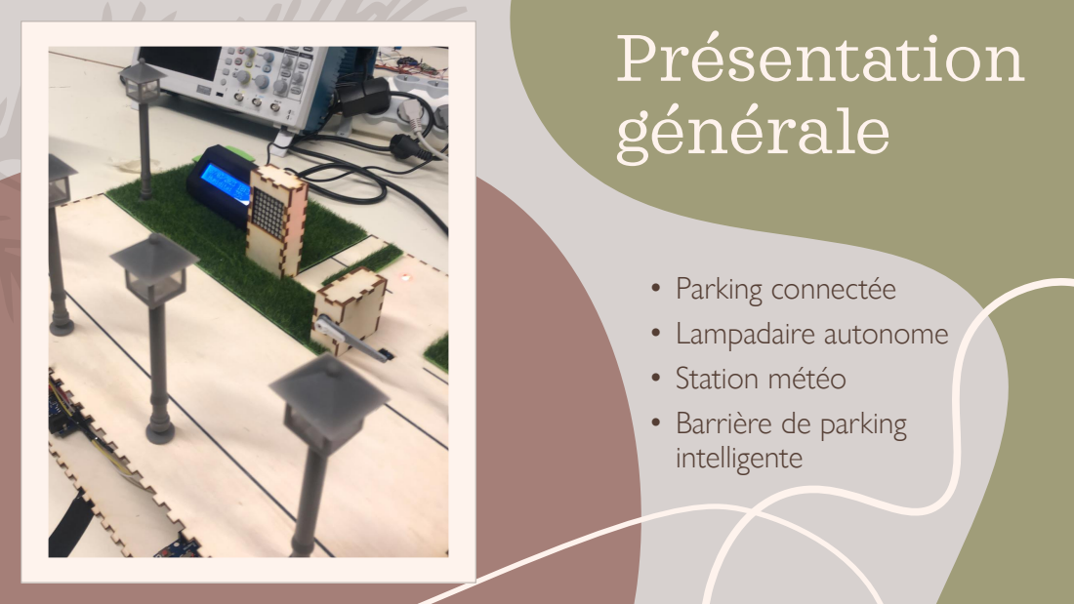
[picture p106: page 4]

• Parking connectée
• Lampadaire autonome
• Station météo
• Barrière de parking
intelligente

# Planning

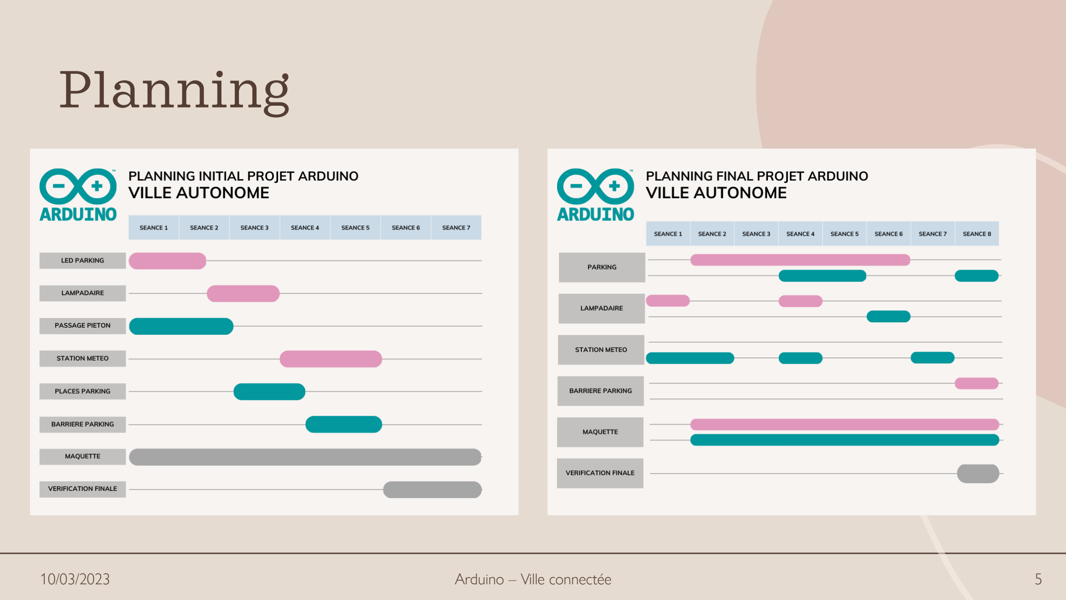
[picture p107: page 5]

# Station météo

# Matériel utilisé

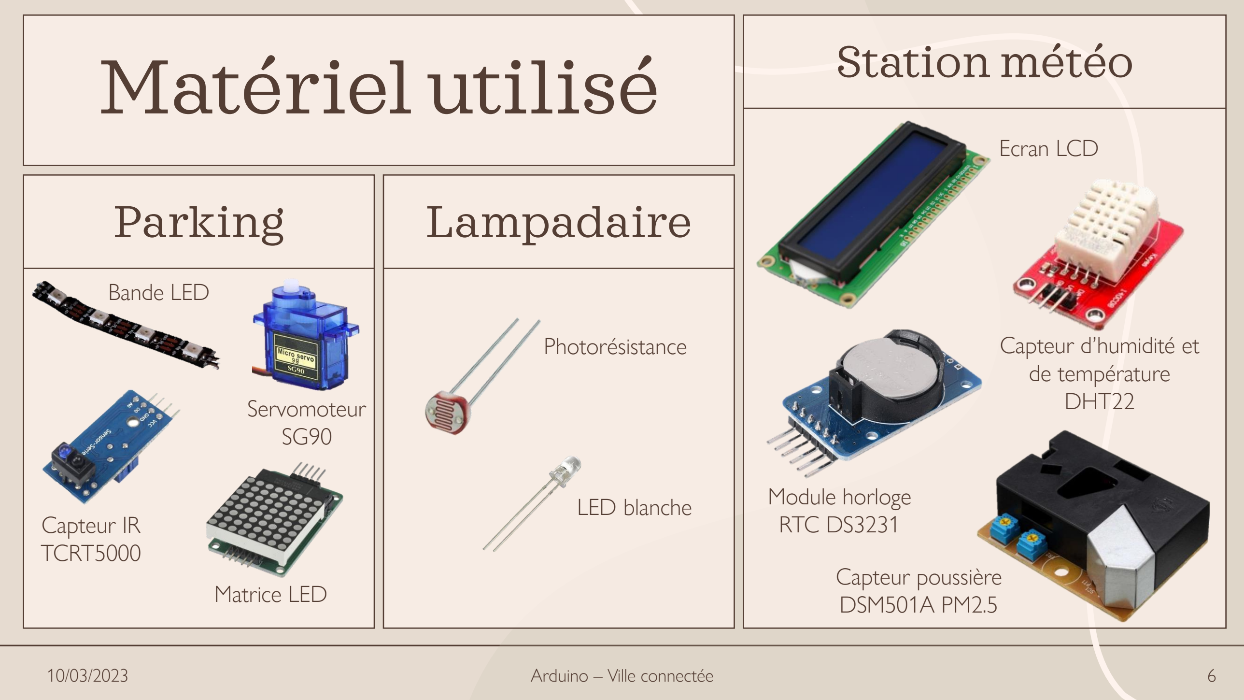
[picture p108: page 6]

Capteur poussière
DSM501A PM2.5

Module horloge
RTC DS3231

Capteur d’humidité et
de température
DHT22

Ecran LCD
Parking | Lampadaire

Bande LED

Servomoteur
SG90

Capteur IR
TCRT5000

Matrice LED

Photorésistance

LED blanche

# Parking

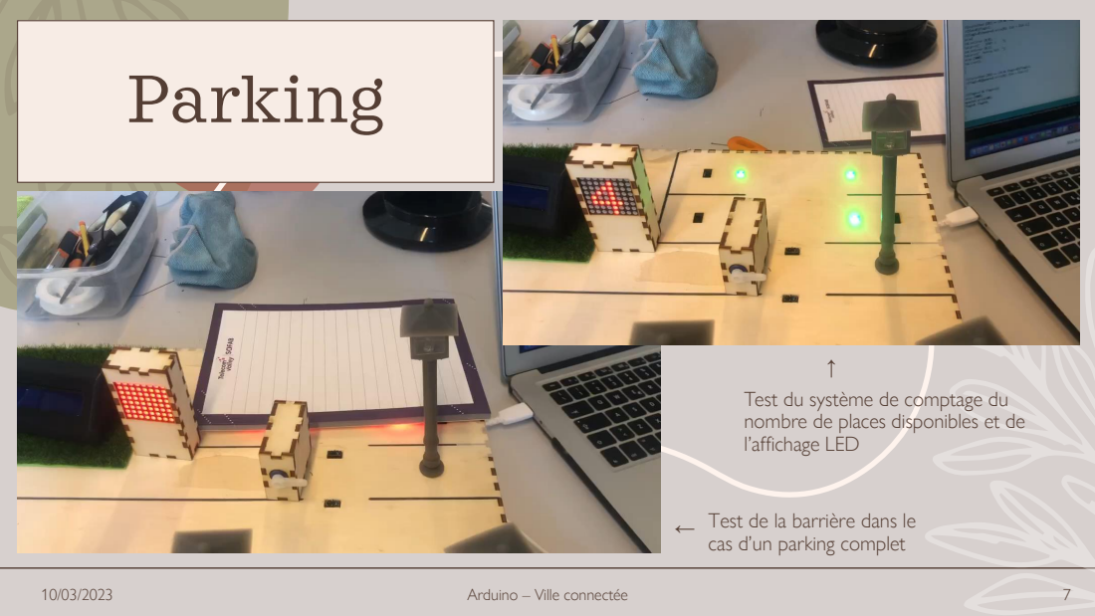
[picture p109: page 7]

Test du système de comptage du
nombre de places disponibles et de
l’affichage LED

← Test de la barrière dans le
cas d’un parking complet

# Parking

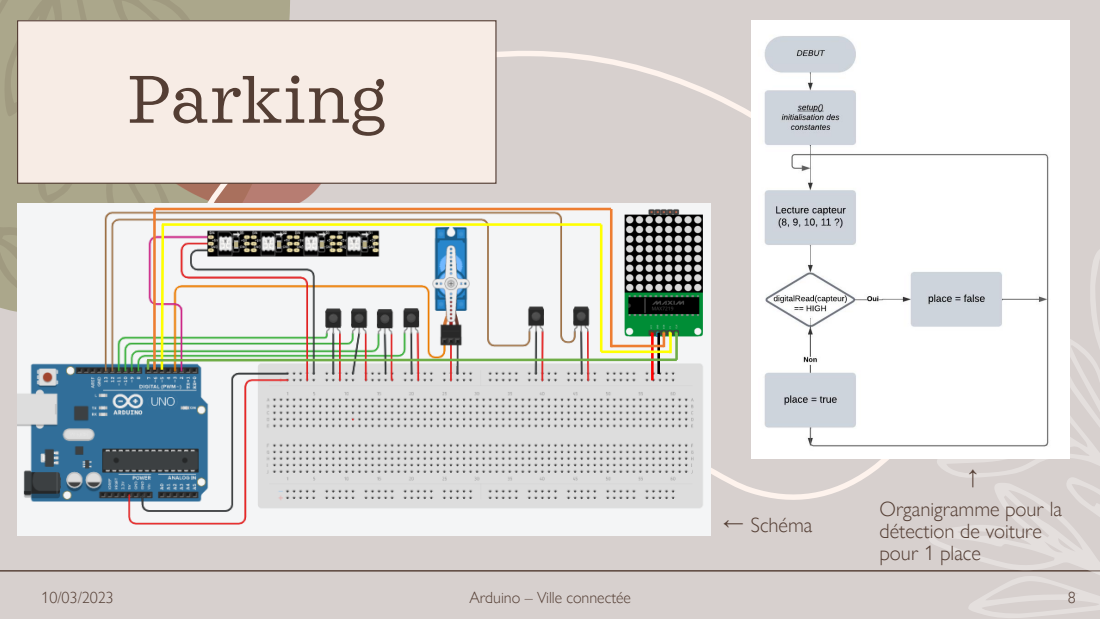
[picture p110: page 8]
← Schéma

Organigramme pour la
détection de voiture
pour 1 place

# Parking

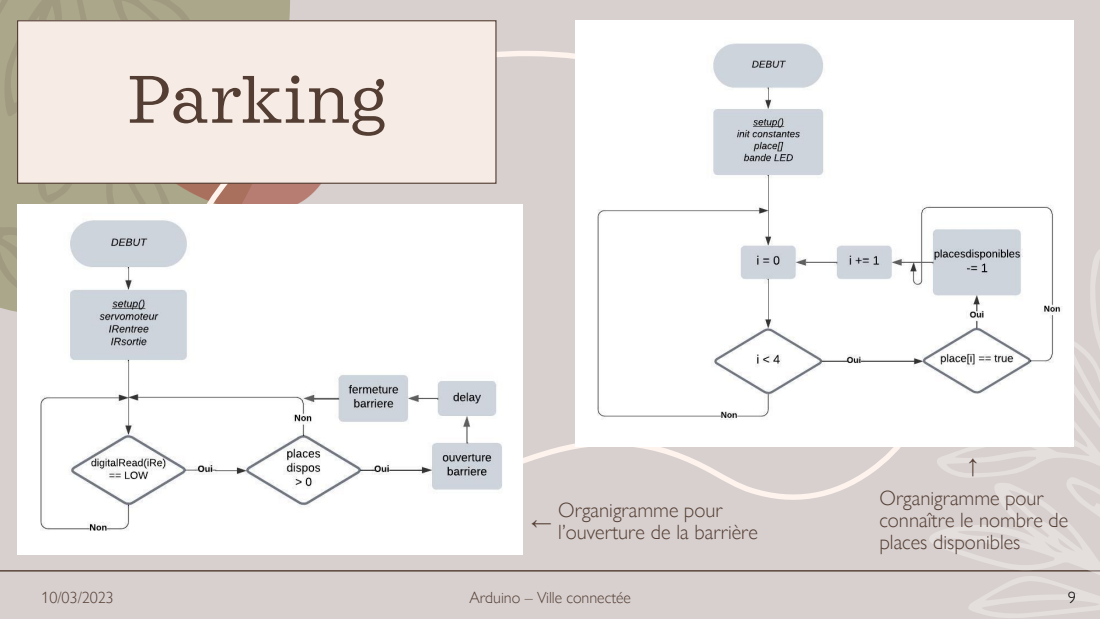
[picture p111: page 9]

Organigramme pour
connaître le nombre de
places disponibles

l’ouverture de la barrière

# Parking

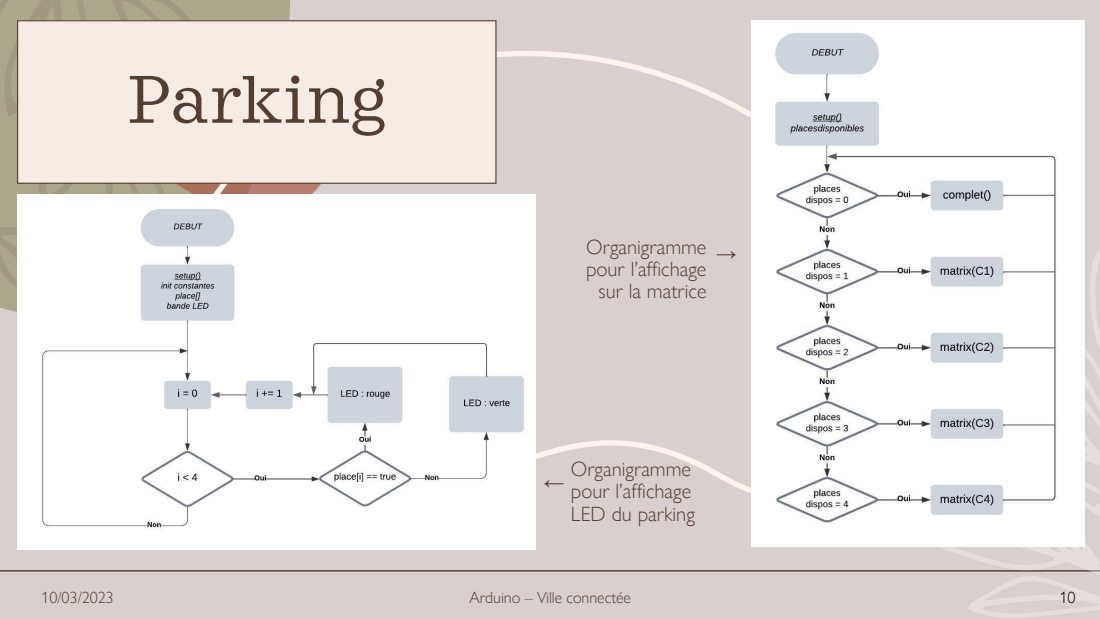
[picture p112: page 10]

Organigramme
pour l’affichage
sur la matrice

LED du parking

# Station météo

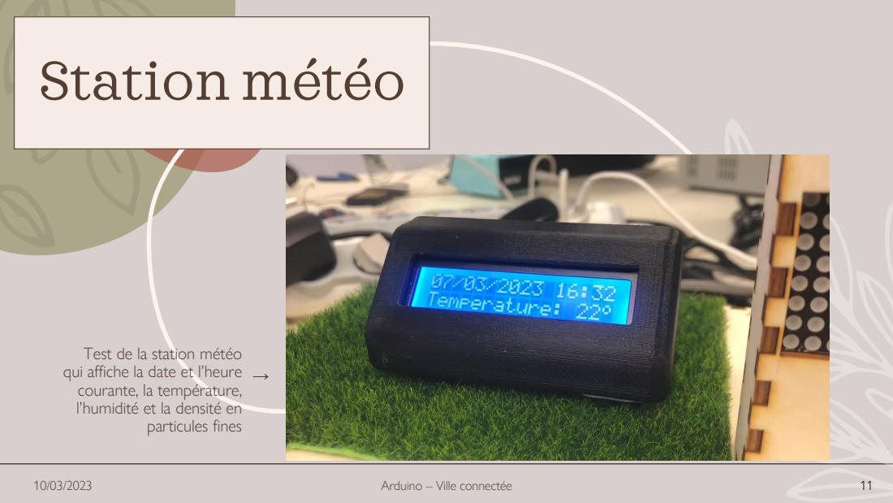
[picture p113: page 11]
particules fines

Test de la station météo
qui affiche la date et l’heure
courante, la température,
l’humidité et la densité en

# Station météo

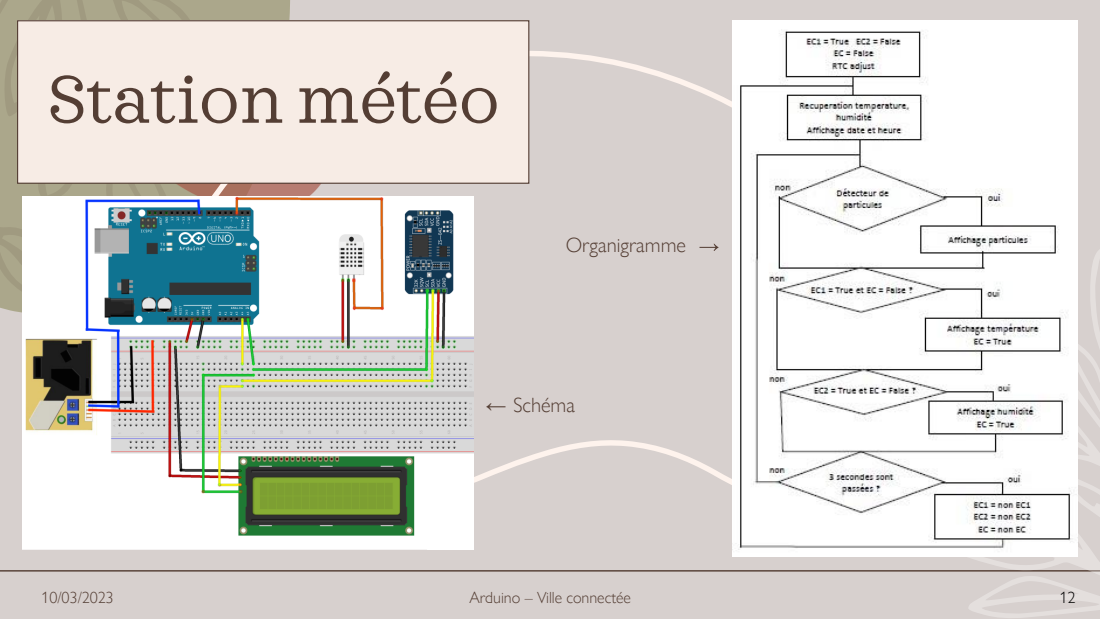
[picture p114: page 12]
Organigramme; ← Schéma

# Lampadaire

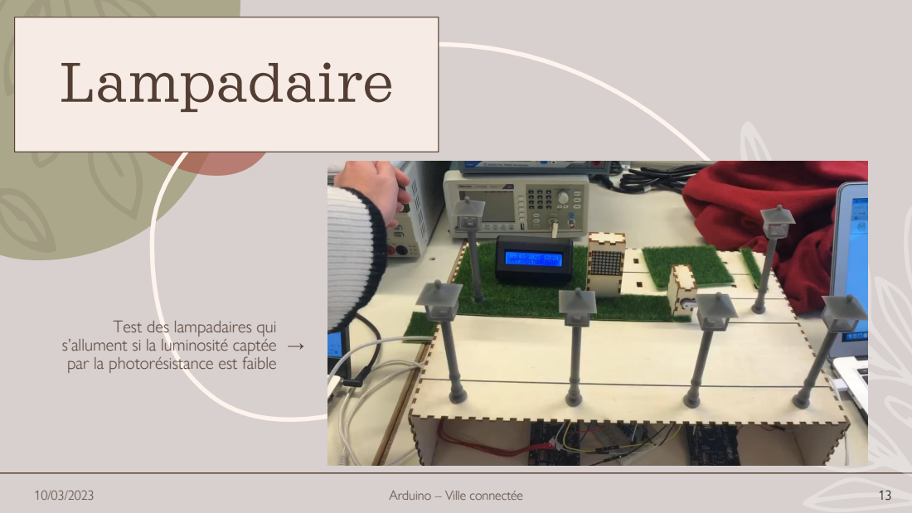
[picture p115: page 13]

Test des lampadaires qui

s’allument si la luminosité captée
par la photorésistance est faible

# Lampadaire

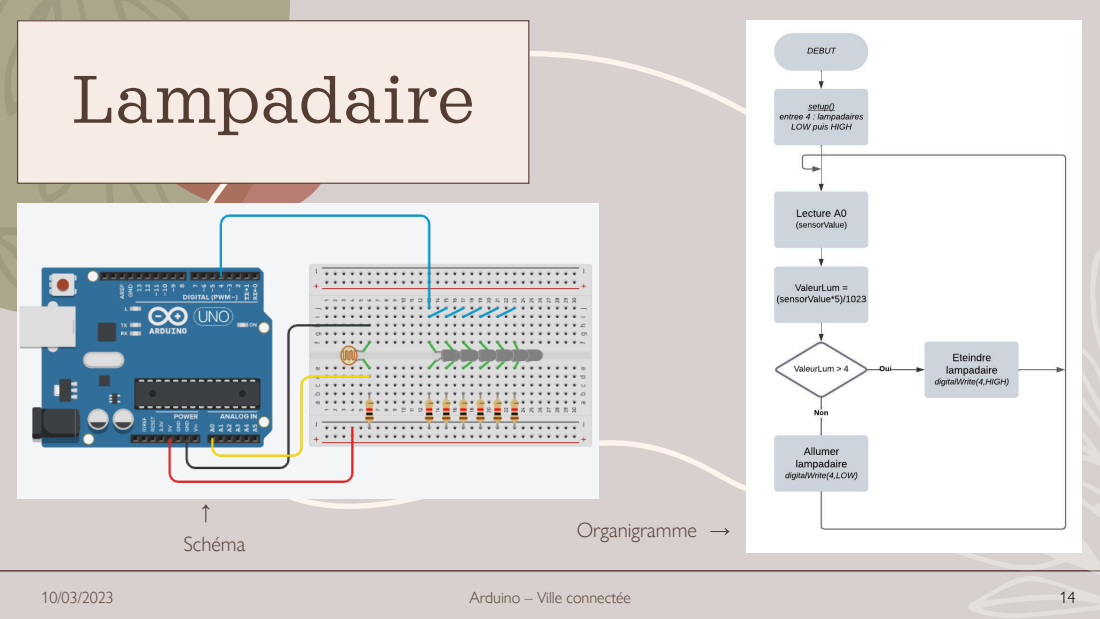
[picture p116: page 14]
Organigramme; Schéma

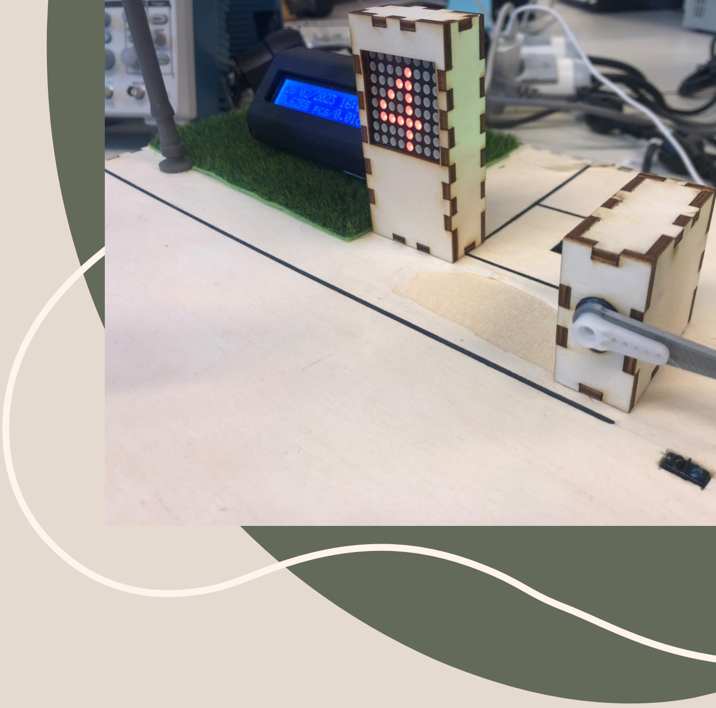
[picture p117: figure]

# Synthèse

- Difficultés rencontrées :
- La durée de la réalisation de la maquette
- L’utilisation des delay
- Idées d’améliorations :
- Passage piéton
- Amélioration de la barrière de parking
- Amélioration des lampadaires
- Apports de ce projet :

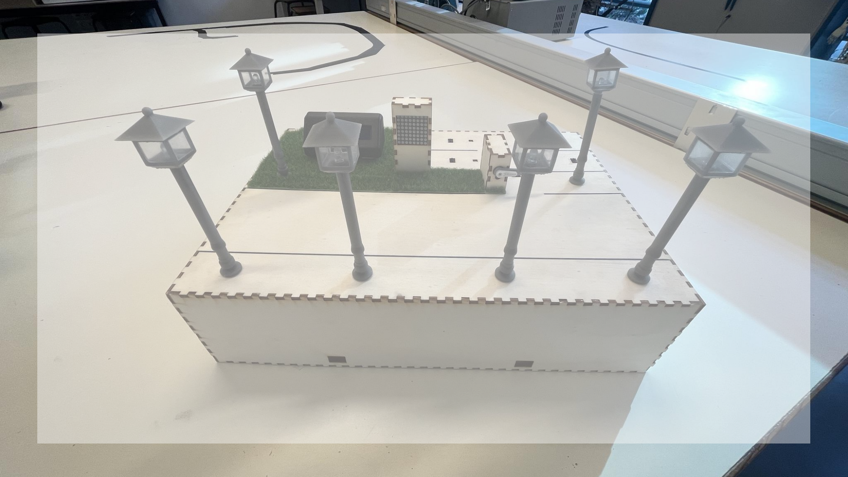
[picture p118: page 16]
