villeautonome/Ville-Connectee/Planning.pdf

# PLANNING PROJET ARDUINO

# VILLE AUTONOME

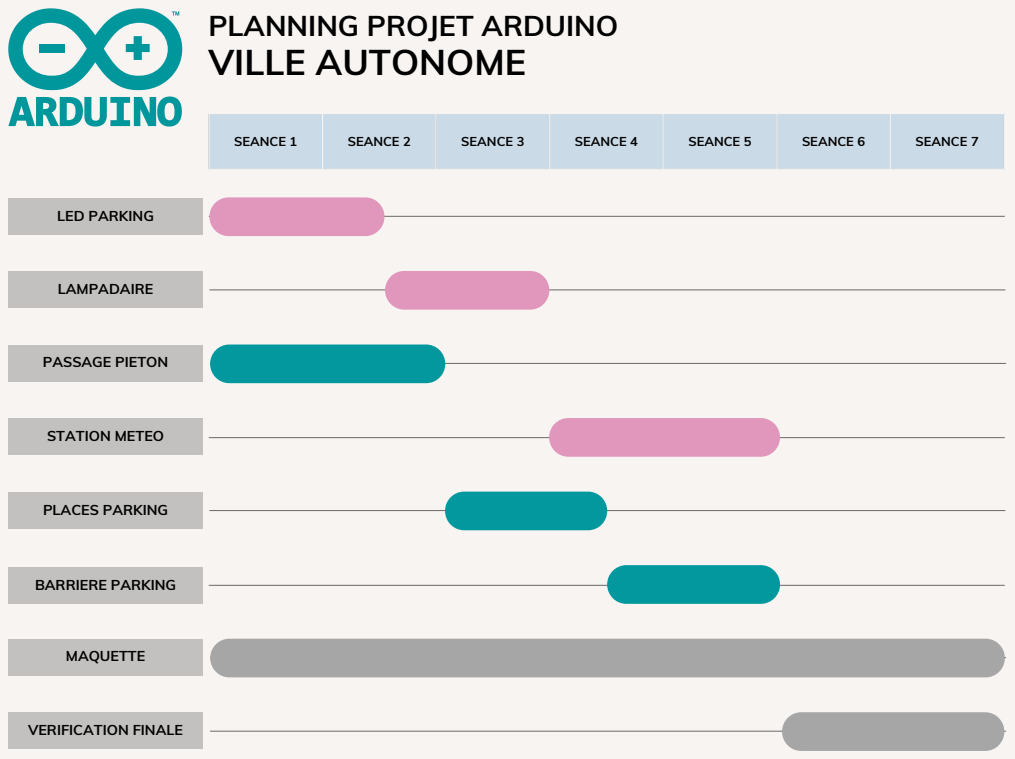
[picture p119: page 1]
SEANCE 1; SEANCE 2; SEANCE 3; SEANCE 4; SEANCE 5; SEANCE 6; SEANCE 7; LED PARKING; LAMPADAIRE; PASSAGE PIETON; STATION METEO; PLACES PARKING; MAQUETTE; BARRIERE PARKING; VERIFICATION FINALE
