villeautonome/Ville-Connectee/rapport séances/Francesco/codes/lampadaires_meteo_v2.ino

#include <LiquidCrystal_I2C.h>
#include <RTClib.h>
#include <Wire.h> //permet de discuter avec différents composants
#include <DHT.h>

// Initialisation du module RTC
RTC_DS3231 rtc;

// Initialisation de l'écrans LCD sur l'adresse 0x27
LiquidCrystal_I2C lcd(0x27, 16, 2);

// Initialisation du capteur DHT22
DHT dht(2, DHT22);

// Initialisation des degrés
byte degre[8] = { 0b01100,0b10010,0b10010,0b01100,0b00000,0b00000,0b00000,0b00000 };

//module qui permet de changer l'affichage de l'écran à des intervalles de temps
unsigned long mymillis;
boolean EC1 = true;
boolean EC2 = false;
boolean EC3 = false;
boolean EC = false;

//initialisation pour les lampadaires
int lampadaire = 4;
int sensorValue;
float sensorValue_f;
float ValeurLum;

//initialisation du détecteur de particules
int pin = 8;
unsigned long duration;
unsigned long starttime;
unsigned long sampletime_ms = 30000;//sampe 30s ;
unsigned long lowpulseoccupancy = 0;
float ratio = 0;
float concentration = 0;

// Fonction setup, appelée une seule fois au démarrage
void setup () {
  // Initialisation du module RTC
  rtc.begin();
  
  // Vérification de l'alimentation de la RTC
  if (rtc.lostPower()) {
    // Si l'alimentation a été perdue, réglage de l'heure
    rtc.adjust(DateTime(F(__DATE__), F(__TIME__)));
  }

  // Initialisation de l'écran LCD
  lcd.init();
  lcd.backlight();
  lcd.clear();
  lcd.createChar(1, degre);
  
  Serial.begin(9600);
  pinMode(4,OUTPUT);
  digitalWrite(4,LOW);
  pinMode(8,INPUT);
  starttime = millis();//get the current time;
}

//Fonction qui affiche la température et l'heure
void temphumpar(){
  // Récupération de l'humidité
  byte h = dht.readHumidity();
  // Récupération de la température
  byte t = dht.readTemperature();

  duration = pulseIn(pin, LOW);
  lowpulseoccupancy = lowpulseoccupancy+duration;
  if ((millis()-starttime) > sampletime_ms){  //if the sampel time == 30s
    ratio = lowpulseoccupancy/(sampletime_ms*10.0);  // Integer percentage 0=>100
    concentration = 1.1*pow(ratio,3)-3.8*pow(ratio,2)+520*ratio+0.62; // using spec sheet curve
    lcd.setCursor(0,1);
    lcd.print(concentration);
    lcd.print(" pcs/0.01cf");
    lowpulseoccupancy = 0;
    starttime = millis();
  }

  // Affichage de la température
  if (EC1 == true && EC == false) {
    lcd.setCursor(0,1);
    lcd.print("Temperature: ");
    lcd.print(t);
    lcd.print(char(1));
    
    // Mise à jour des variables pour éviter les répétitions
    EC = true;
    mymillis = millis();
  }
  
  // Affichage de l'humidité
  if (EC2 == true && EC == false) {
    lcd.setCursor(0,1);
    lcd.print(" Humidite: ");
    lcd.print(h);
    lcd.print("%   ");

    // Mise à jour des variables pour éviter les répétitions
    EC = true;
    mymillis = millis();
  }

  // Changement d'interface toutes les 3 secondes
  if (millis() - mymillis >= 3000) { 
    EC1 = !EC1;
    EC2 = !EC2;
    EC = false;
  }
}

//fonction qui affiche la date et l'heure
void printDateTime(DateTime dt) {
  char dateBuffer[] = "DD/MM/YYYY hh:mm";

  lcd.setCursor(0,0);
  lcd.print(dt.toString(dateBuffer));
}

// Fonction loop, appelée en boucle
void loop () {
  // Récupération de l'heure courante
  DateTime now = rtc.now();
  
  // Affichage de l'heure sur l'écran LCD
  printDateTime(now);
  
  //délais qui laisse le temps au capteur de récupéré la température et l'humidté
  delay(1000);

  temphumpar(); //appel de la fonction qui affiche température/humidité

  sensorValue = analogRead(A0); //lecture de la valeur numérique
  sensorValue_f = sensorValue;
  ValeurLum = (sensorValue_f*5)/1023;

  Serial.println(ValeurLum);
  
  if (ValeurLum > 4) {
    digitalWrite(lampadaire,LOW);
  }
  else {
    digitalWrite(lampadaire,HIGH);
  }
}
