villeautonome/Ville-Connectee/rapport séances/Francesco/images/planche_cote.jpeg

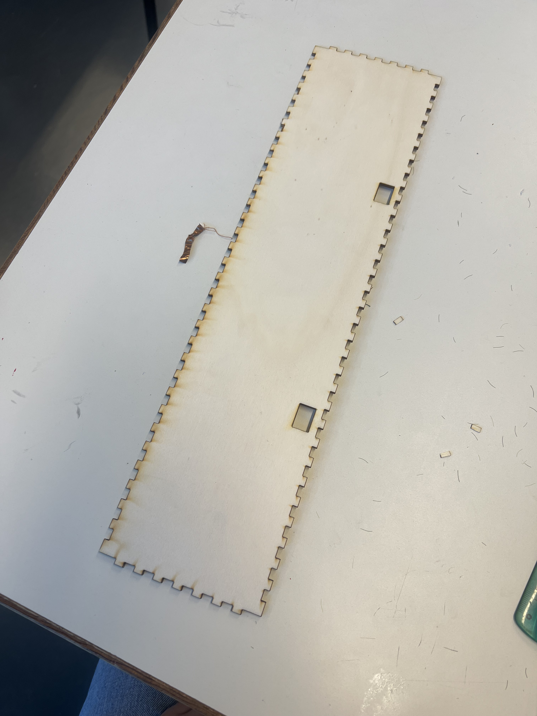
[picture p77: rapport séances/Francesco/images/planche_cote.jpeg]
rapport séances/Francesco/images/planche_cote.jpeg
