villeautonome/Ville-Connectee/rapport séances/Francesco/images/herbe_maquette.jpeg

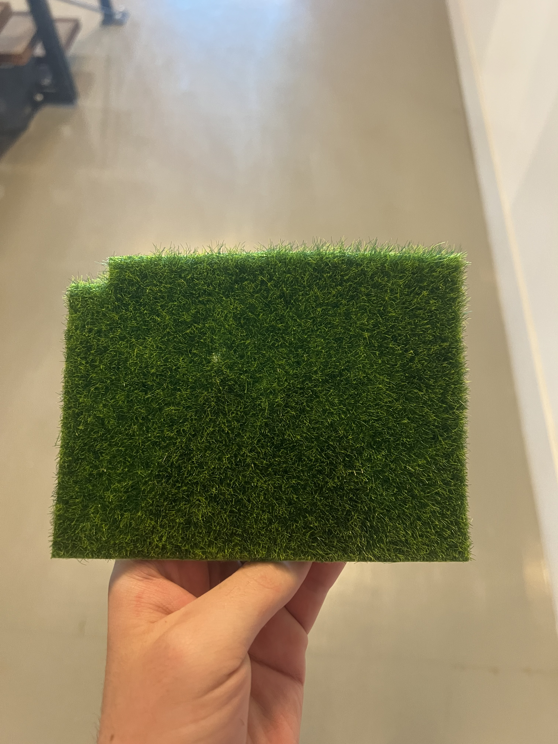
[picture p78: rapport séances/Francesco/images/herbe_maquette.jpeg]
rapport séances/Francesco/images/herbe_maquette.jpeg
