villeautonome/Ville-Connectee/rapport séances/Francesco/images/statio_meteo_fin.jpeg

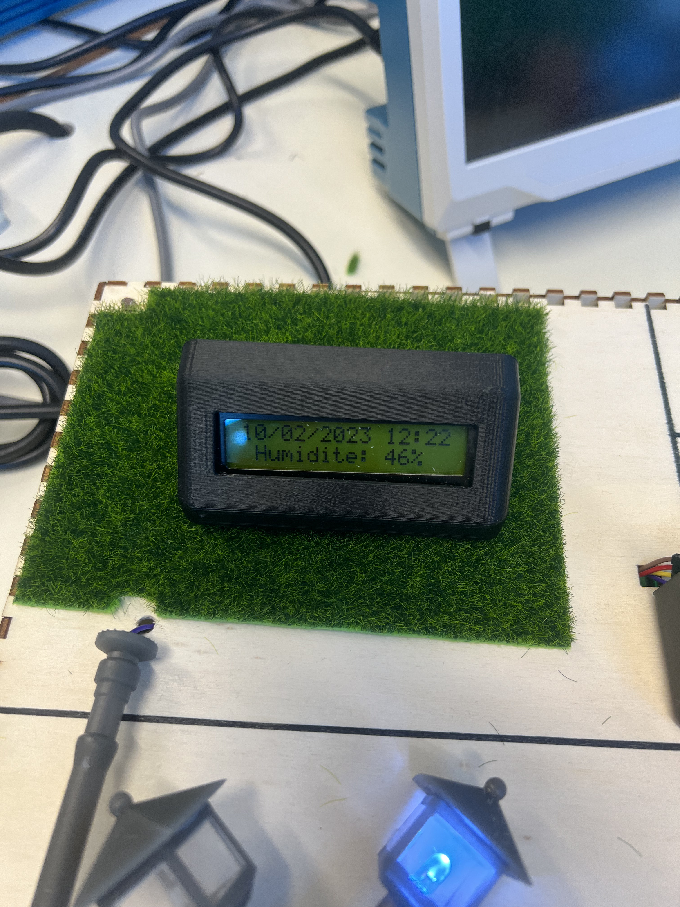
[picture p79: rapport séances/Francesco/images/statio_meteo_fin.jpeg]
rapport séances/Francesco/images/statio_meteo_fin.jpeg
