villeautonome/Ville-Connectee/rapport séances/Francesco/images/lampadaire_casse.jpeg

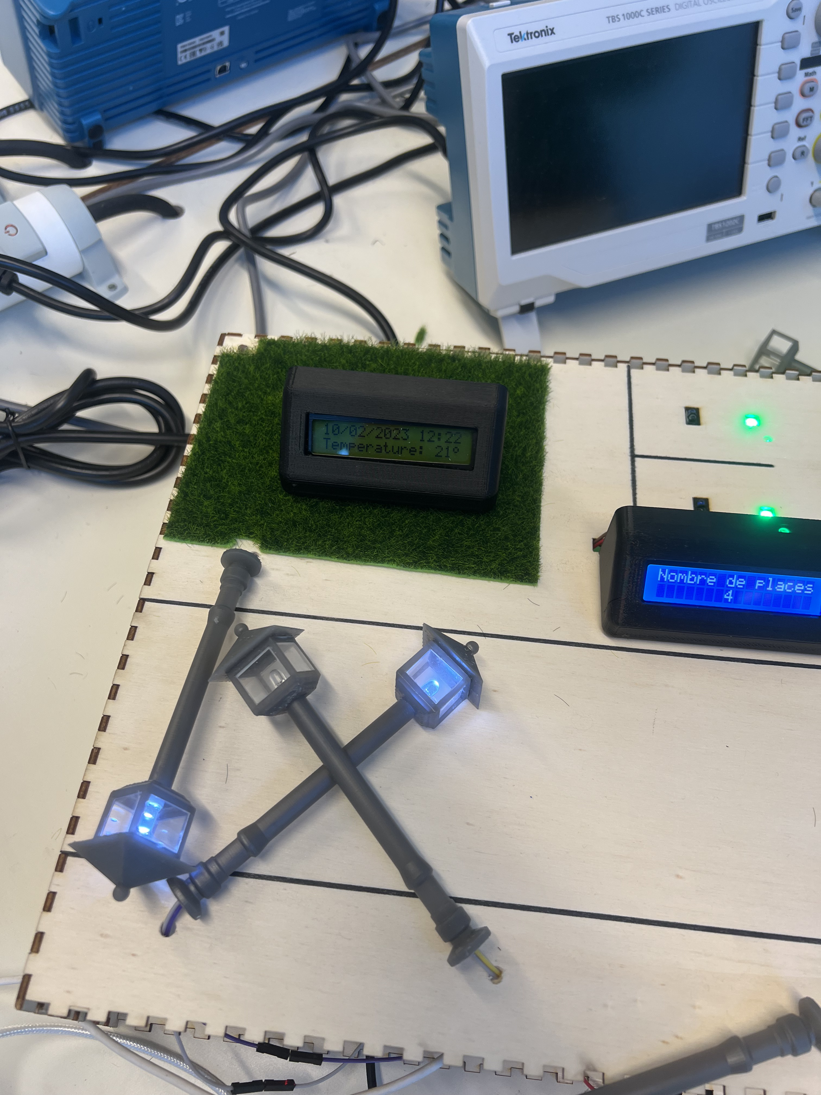
[picture p81: rapport séances/Francesco/images/lampadaire_casse.jpeg]
rapport séances/Francesco/images/lampadaire_casse.jpeg
